TheGreatChris/ethernet-sniffer/model/RJMG1BD3B8K1ANR.STEP

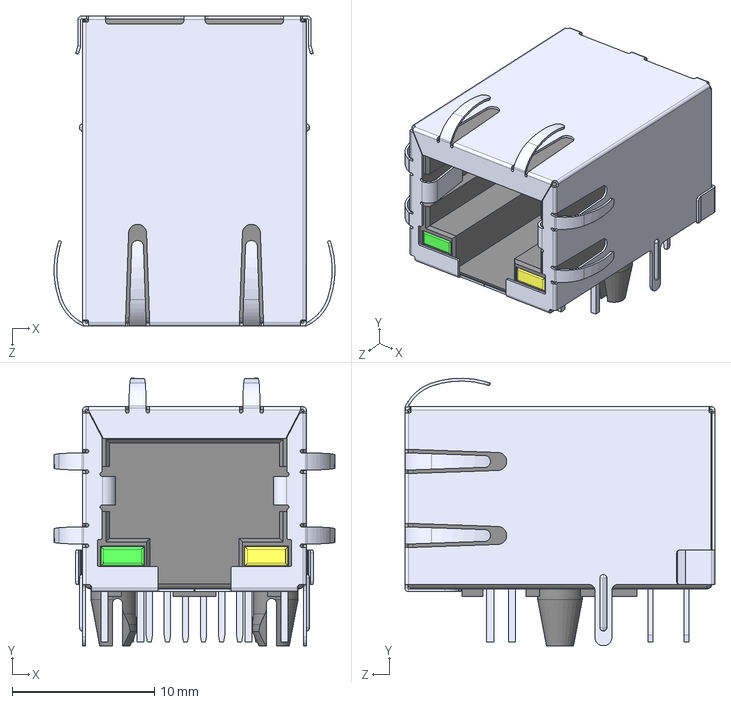
[picture p1: CAD file, 2020-06-23]
model/RJMG1BD3B8K1ANR.STEP
19.7 x 18.8 x 21.8 mm
