TheGreatChris/ethernet-sniffer/model/10118192C.stp

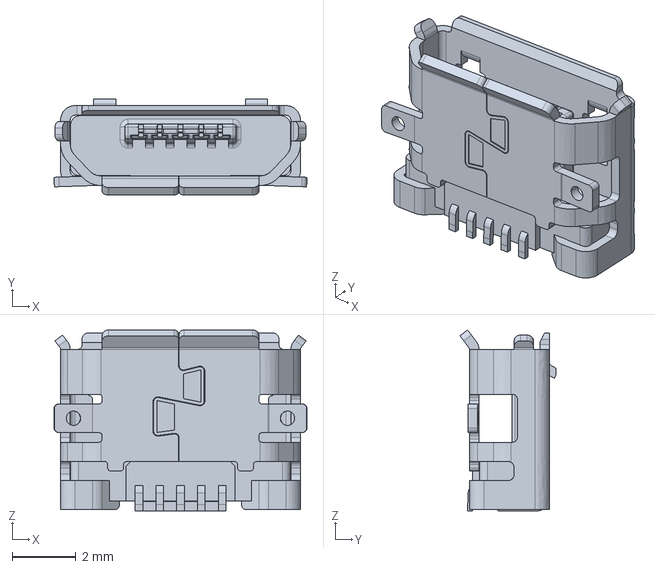
[picture p2: CAD file, 2020-06-23]
model/10118192C.stp
7.91 x 3.01 x 5.66 mm
