TheGreatChris/ethernet-sniffer/assembly/1.PNG

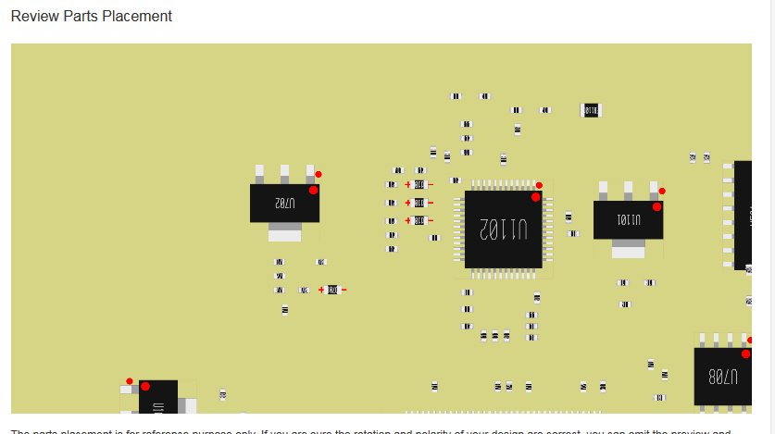
assembly/1.PNG
