TheGreatChris/ethernet-sniffer/assembly/2.PNG

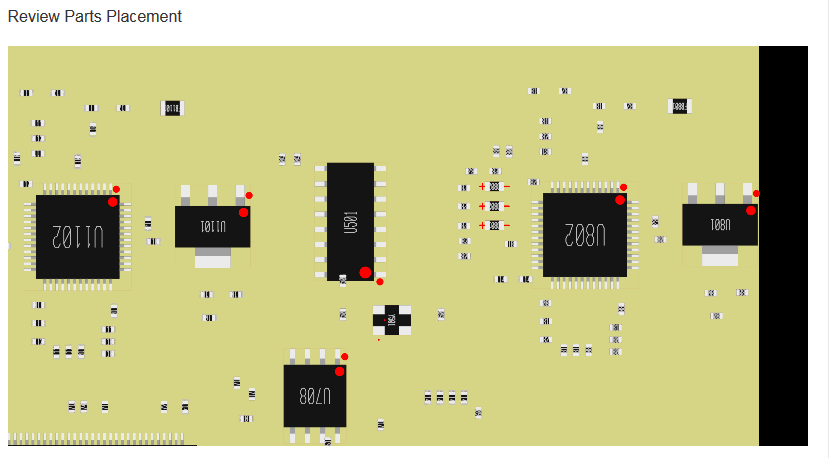
assembly/2.PNG
