TheGreatChris/ethernet-sniffer/assembly/3.PNG

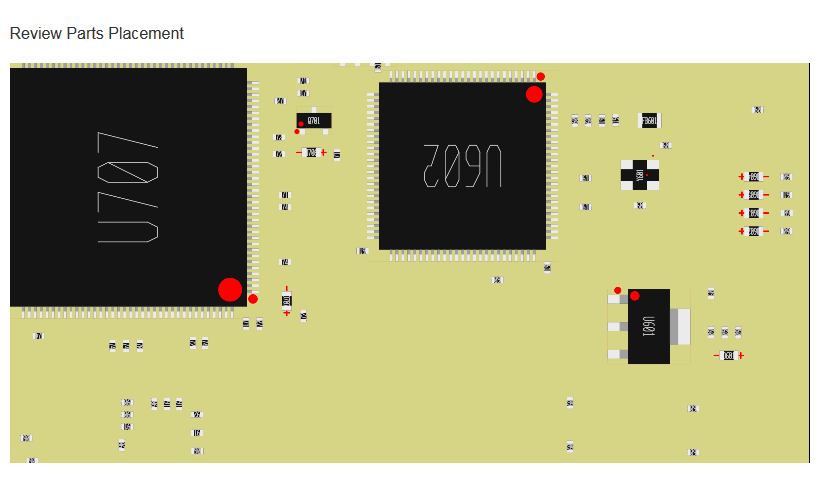
assembly/3.PNG
