TheGreatChris/ethernet-sniffer/assembly/4.PNG

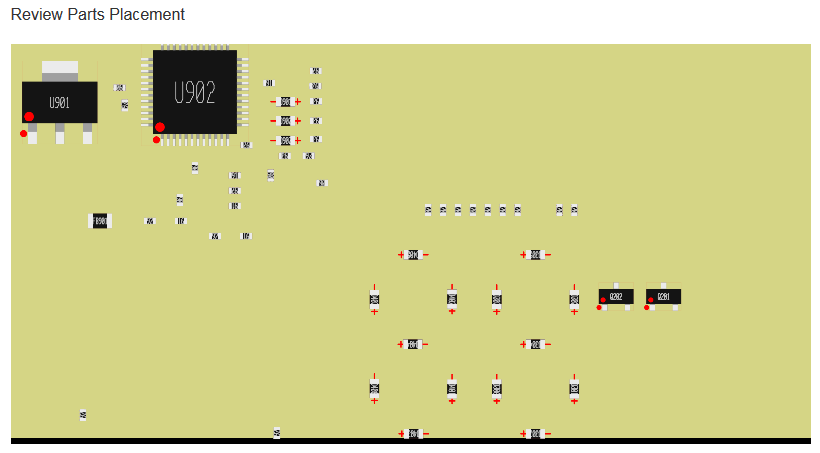
assembly/4.PNG
