TheGreatChris/ethernet-sniffer/assembly/5.PNG

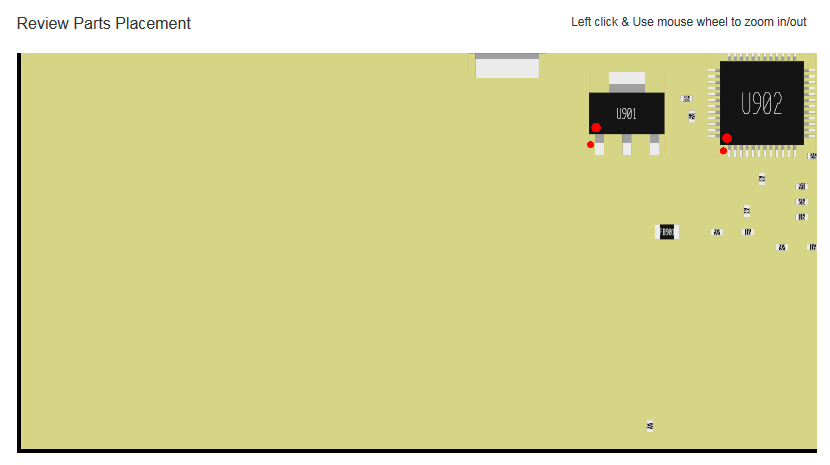
assembly/5.PNG
