TheGreatChris/ethernet-sniffer/assembly/6.PNG

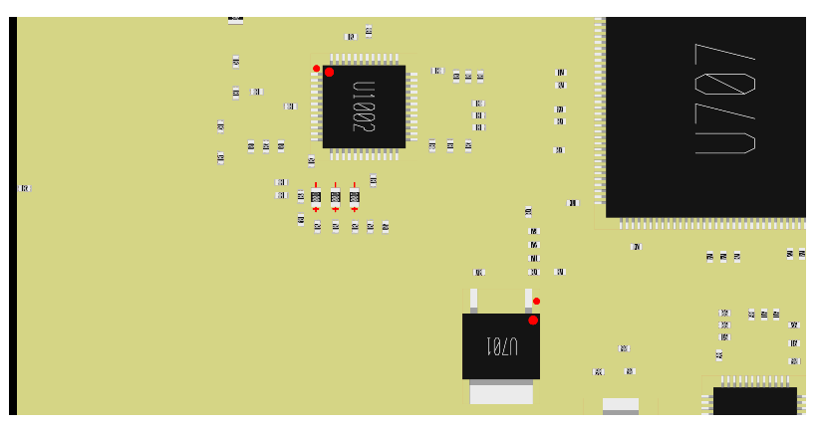
assembly/6.PNG
