TheGreatChris/ethernet-sniffer/assembly/7.PNG

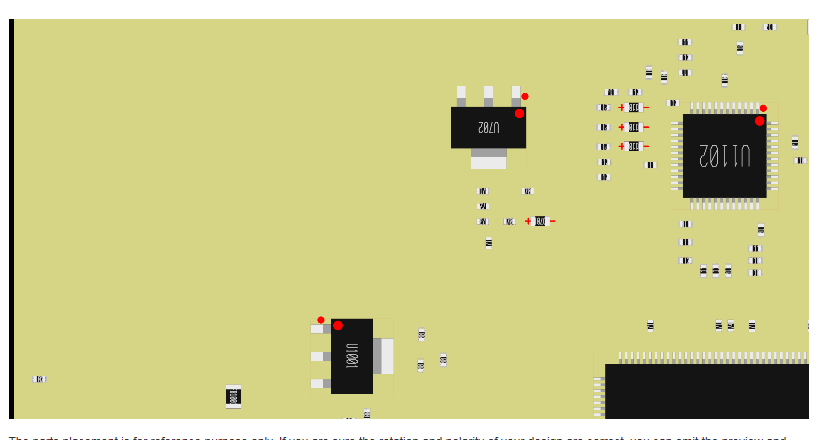
assembly/7.PNG
