TheGreatChris/ethernet-sniffer/assembly/total.png

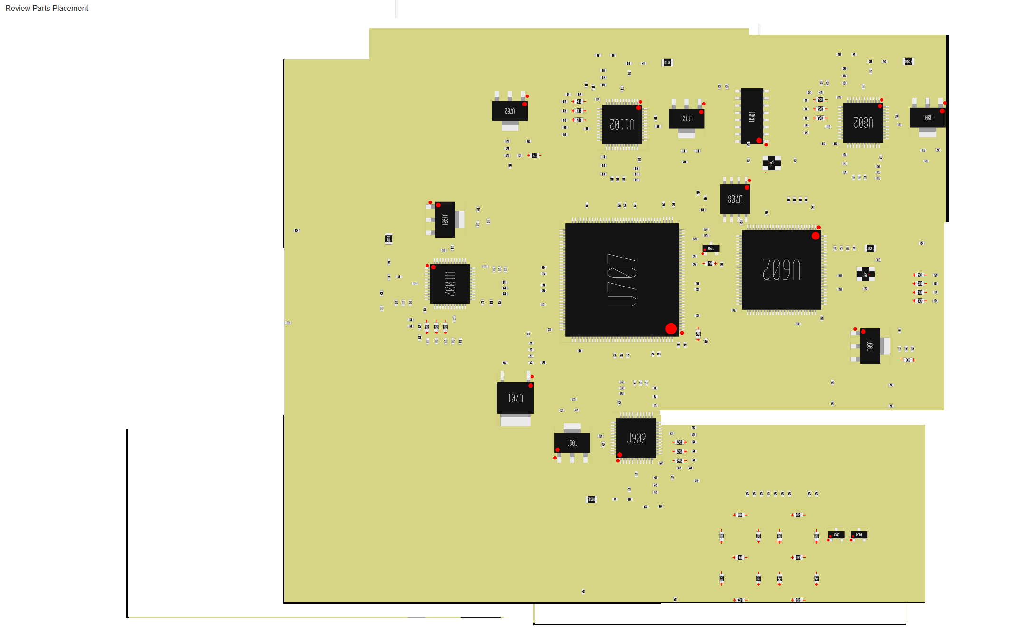
assembly/total.png
