TheGreatChris/ethernet-sniffer/ethernet-sniffer.kicad_pcb

## KiCad design ethernet-sniffer.kicad_pcb (2020-06-25)

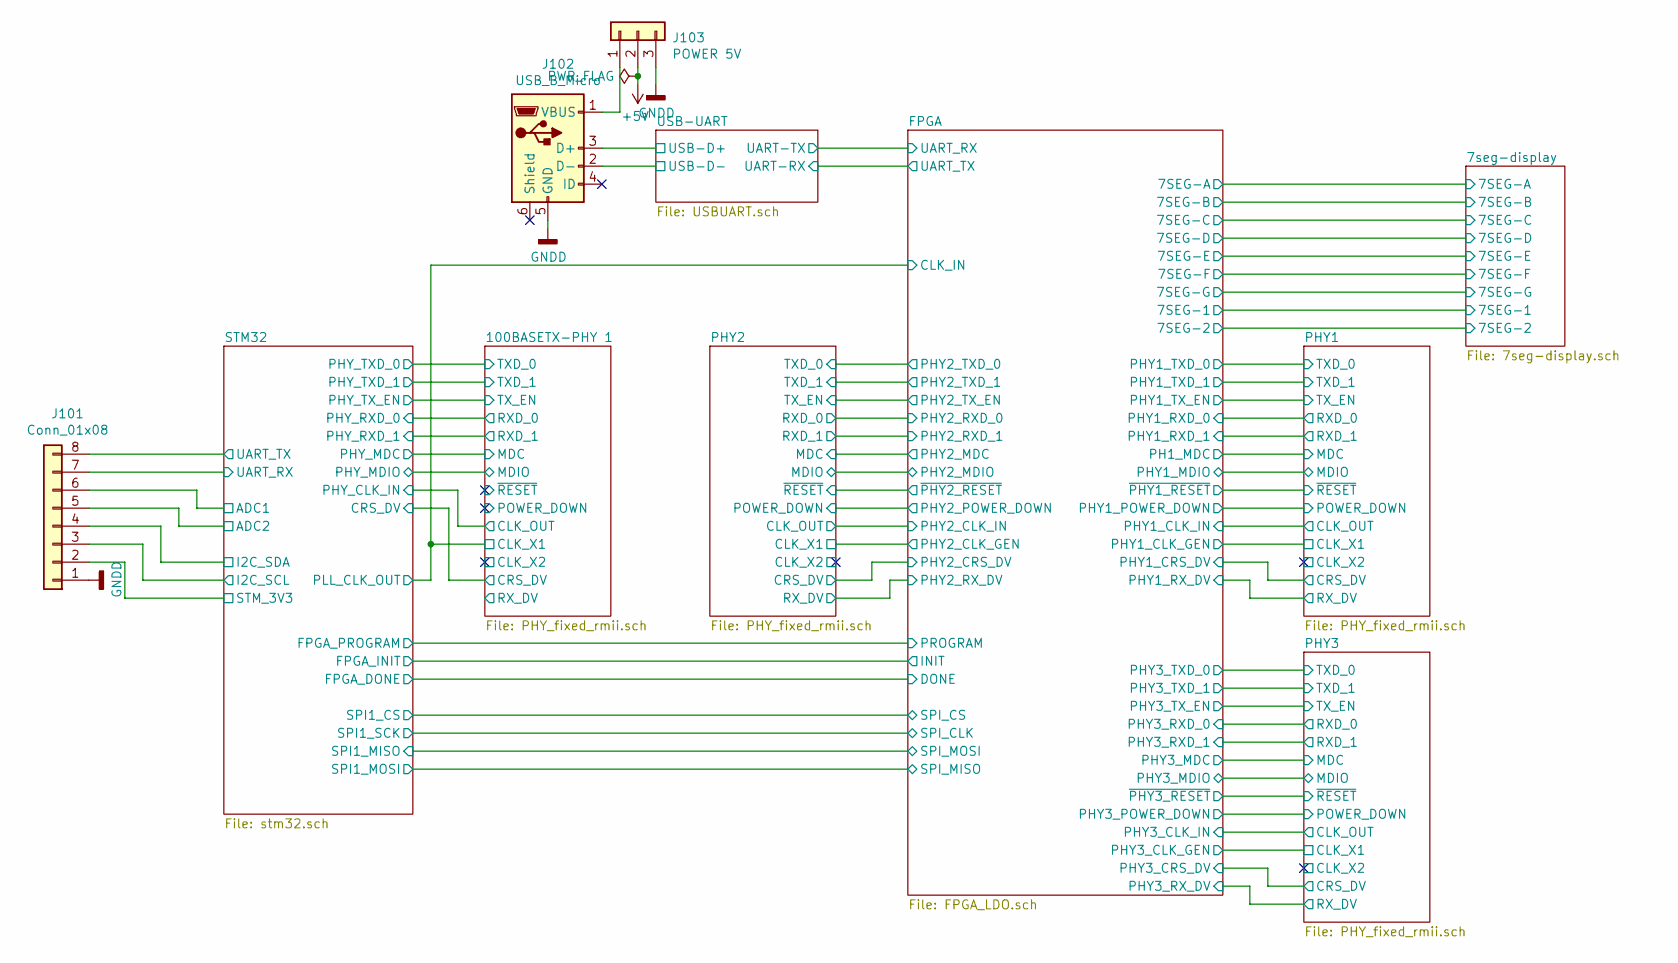
[picture p11: schematic ethernet-sniffer.sch]

Parts:
J101: Conn_01x08; PinHeader_1x08_P2.54mm_Vertical
J102: USB_B_Micro; USB_Micro-B_Amphenol_10103594-0001LF_Horizontal
J103: POWER 5V; PinHeader_1x03_P2.54mm_Vertical

Connections:
+5V: J103.2; also elsewhere on the board
/STM32/ADC1: J101.6; also elsewhere on the board
/STM32/ADC2: J101.5; also elsewhere on the board
/STM32/I2C_SCL: J101.3; also elsewhere on the board
/STM32/I2C_SDA: J101.4; also elsewhere on the board
/STM32/STM_3V3: J101.2; also elsewhere on the board
/STM32/UART_RX: J101.7; also elsewhere on the board
/STM32/UART_TX: J101.8; also elsewhere on the board
/USB-UART/USB-D+: J102.3 (D+); also elsewhere on the board
/USB-UART/USB-D-: J102.2 (D-); also elsewhere on the board
GNDD: J101.1, J102.5 (GND), J103.3; also elsewhere on the board
unnamed: J102.1 (VBUS), J103.1

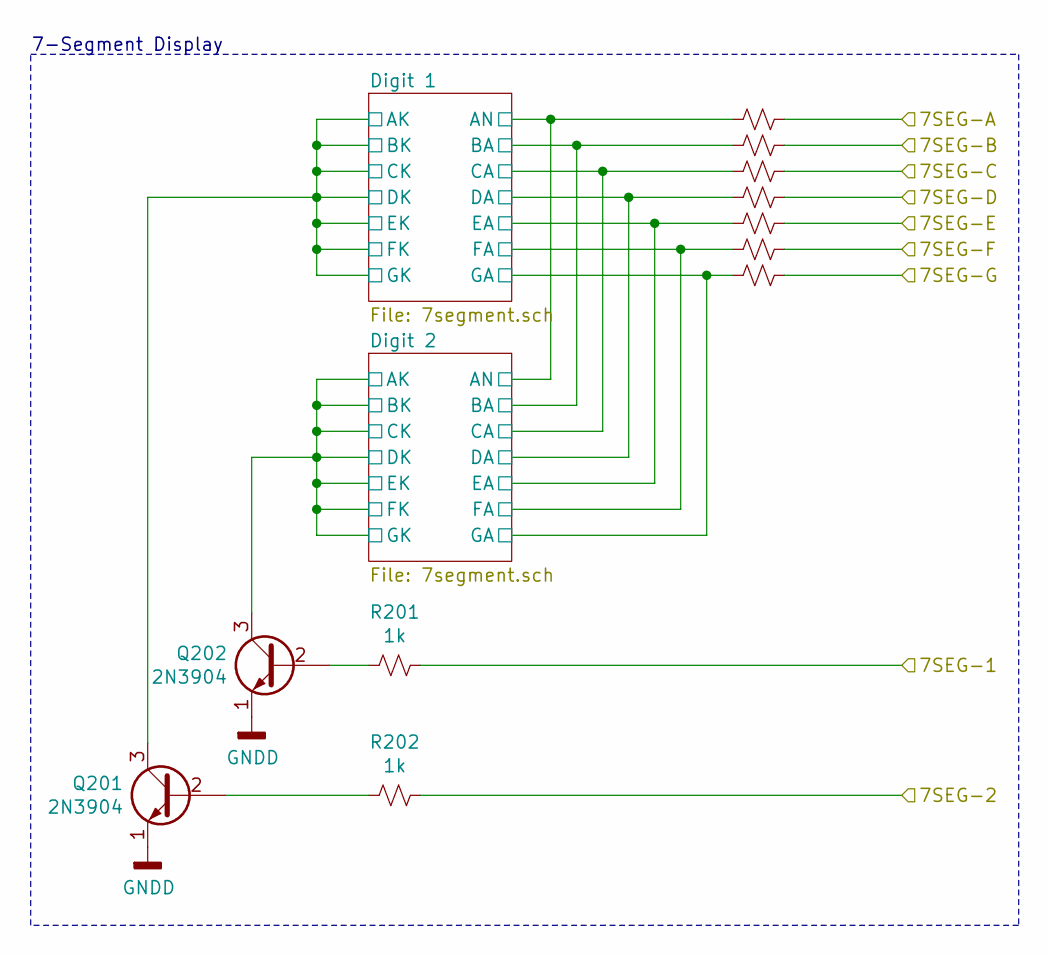
[picture p12: schematic 7seg-display.sch]

Parts:
Q201, Q202: 2N3904; SOT-23
R201, R202: 1k; R_0402_1005Metric
R203, R204, R205, R206, R207, R208, R209: 200; R_0402_1005Metric

Connections:
/7seg-display/7SEG-1: R201.1; also elsewhere on the board
/7seg-display/7SEG-2: R202.1; also elsewhere on the board
/7seg-display/7SEG-A: R203.1; also elsewhere on the board
/7seg-display/7SEG-B: R204.1; also elsewhere on the board
/7seg-display/7SEG-C: R205.1; also elsewhere on the board
/7seg-display/7SEG-D: R206.1; also elsewhere on the board
/7seg-display/7SEG-E: R207.1; also elsewhere on the board
/7seg-display/7SEG-F: R208.1; also elsewhere on the board
/7seg-display/7SEG-G: R209.1; also elsewhere on the board
/7seg-display/Digit 1/AK: Q201.3 (C); also elsewhere on the board
/7seg-display/Digit 1/AN: R203.2; also elsewhere on the board
/7seg-display/Digit 1/BA: R204.2; also elsewhere on the board
/7seg-display/Digit 1/CA: R205.2; also elsewhere on the board
/7seg-display/Digit 1/DA: R206.2; also elsewhere on the board
/7seg-display/Digit 1/EA: R207.2; also elsewhere on the board
/7seg-display/Digit 1/FA: R208.2; also elsewhere on the board
/7seg-display/Digit 1/GA: R209.2; also elsewhere on the board
/7seg-display/Digit 2/AK: Q202.3 (C); also elsewhere on the board
GNDD: Q201.1 (E), Q202.1 (E); also elsewhere on the board
unnamed: Q201.2 (B), R202.2
unnamed: Q202.2 (B), R201.2

Notes on the sheet:
7-Segment Display

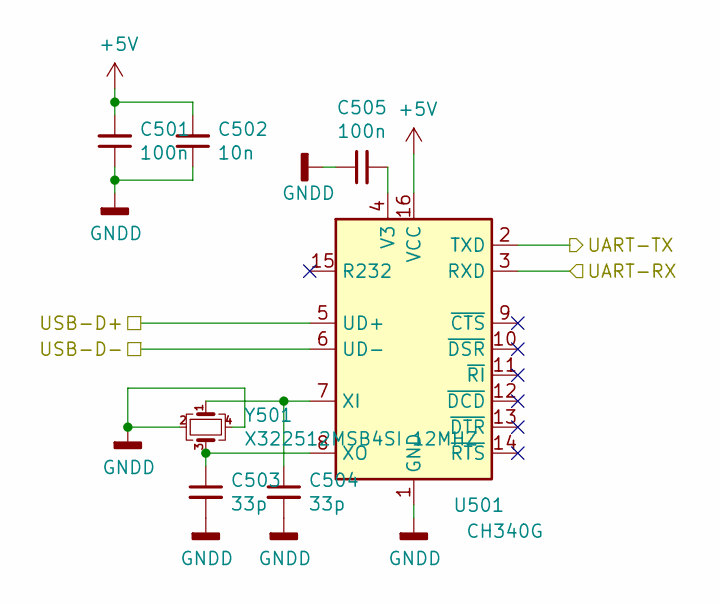
[picture p13: schematic USBUART.sch]

Parts:
C501, C505: 100n; C_0402_1005Metric
C502: 10n; C_0402_1005Metric
C503, C504: 33p; C_0402_1005Metric
U501: CH340G; SOIC-16_3.9x9.9mm_P1.27mm
Y501: X322512MSB4SI 12MHZ; Crystal_SMD_3225-4Pin_3.2x2.5mm

Connections:
+5V: C501.2, C502.2, U501.16 (VCC); also elsewhere on the board
/USB-UART/UART-RX: U501.3 (RXD); also elsewhere on the board
/USB-UART/UART-TX: U501.2 (TXD); also elsewhere on the board
/USB-UART/USB-D+: U501.5 (UD+); also elsewhere on the board
/USB-UART/USB-D-: U501.6 (UD-); also elsewhere on the board
GNDD: C501.1, C502.1, C503.2, C504.2, C505.1, U501.1 (GND), Y501.2, Y501.4; also elsewhere on the board
unnamed: C503.1, U501.8 (XO), Y501.3
unnamed: C504.1, U501.7 (XI), Y501.1
unnamed: C505.2, U501.4 (V3)

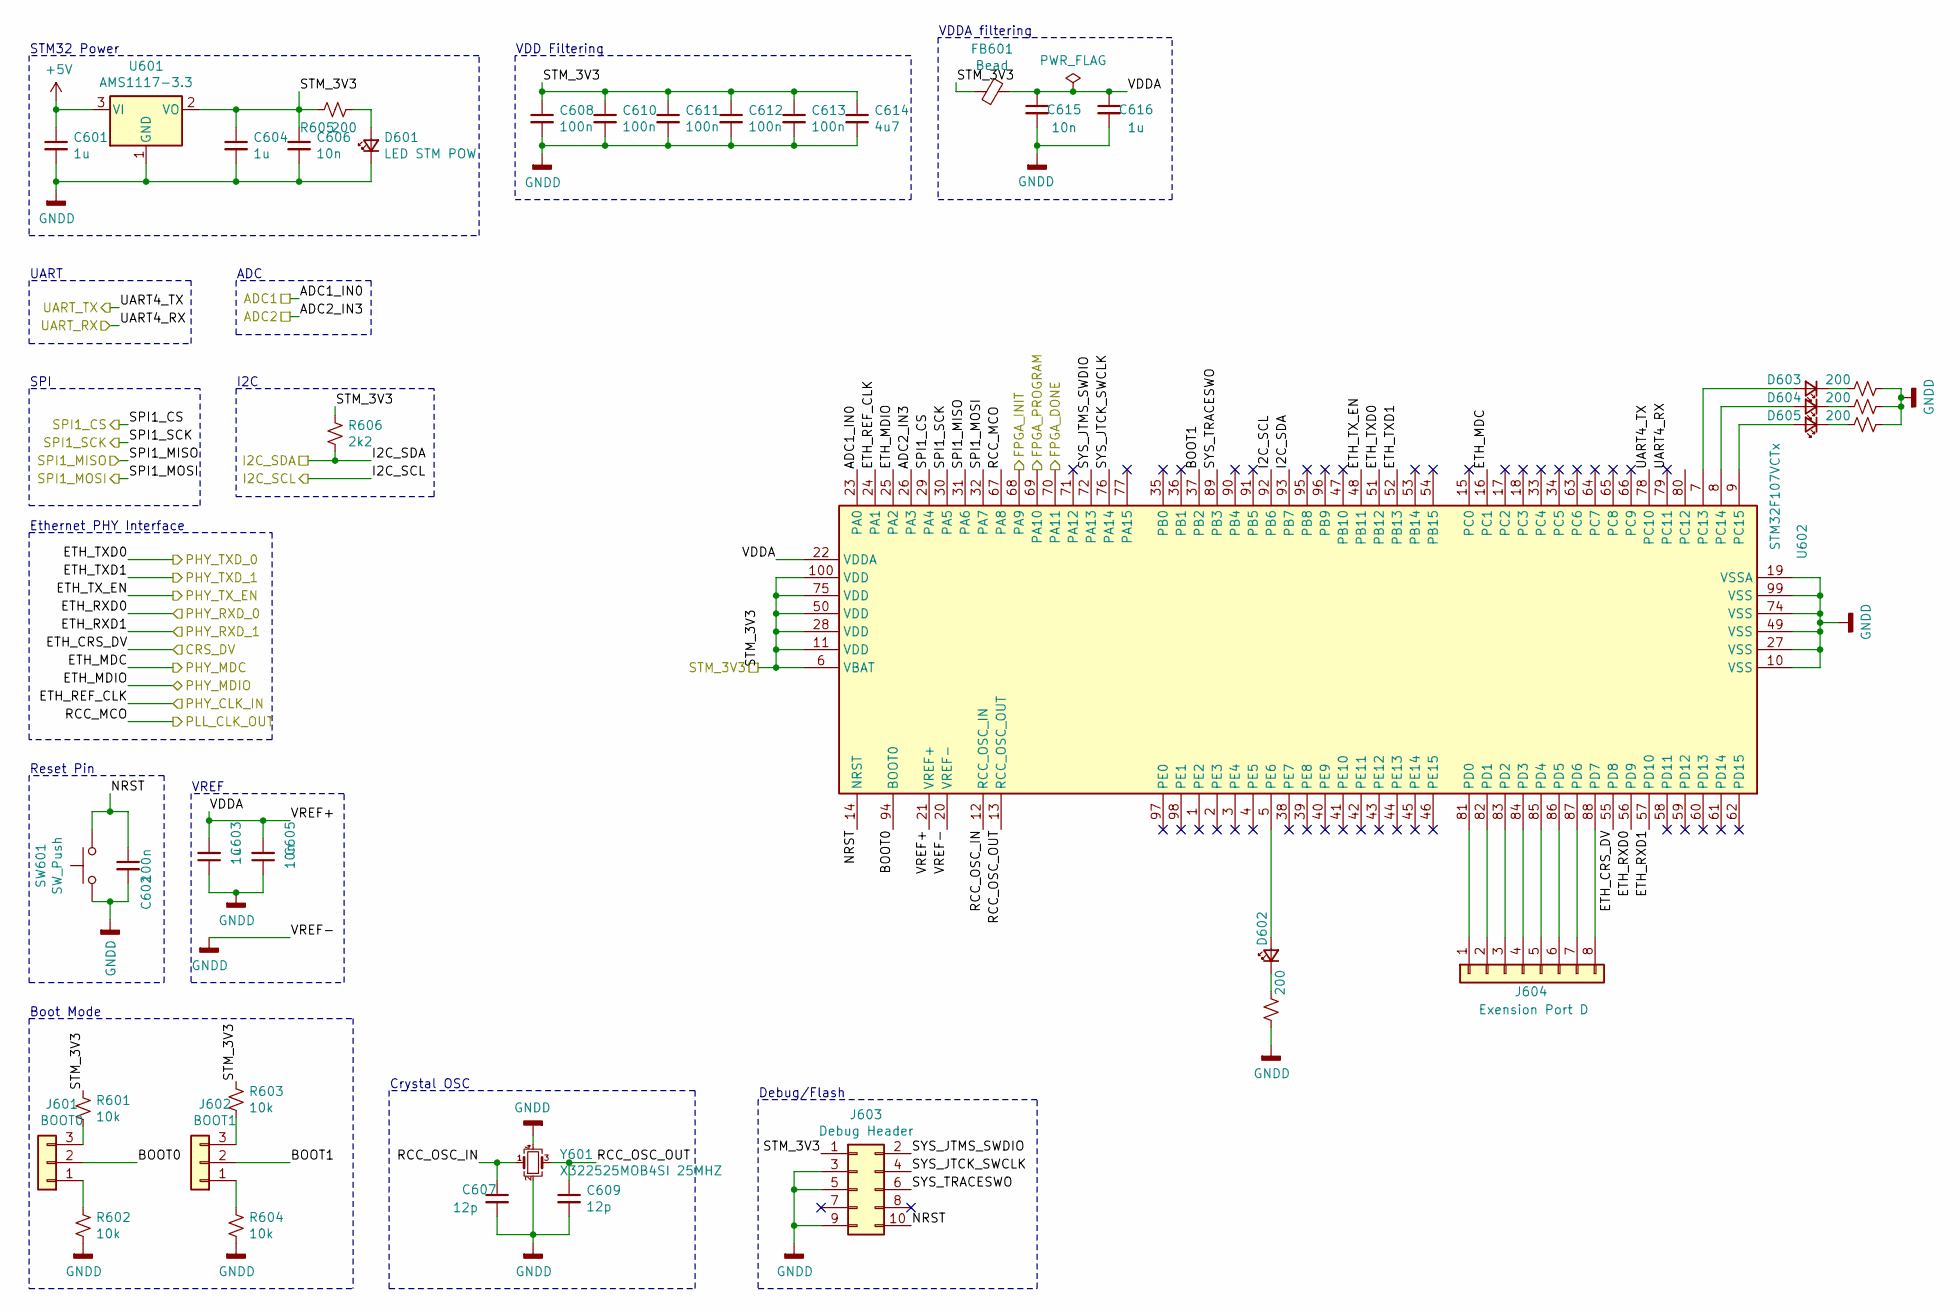
[picture p14: schematic stm32.sch]

Parts:
C601, C603, C604, C616: 1u; C_0402_1005Metric
C602, C608, C610, C611, C612, C613: 100n; C_0402_1005Metric
C605, C606, C615: 10n; C_0402_1005Metric
C607, C609: 12p; C_0402_1005Metric
C614: 4u7; C_0402_1005Metric
D601: LED STM POW; LED_0603_1608Metric
D602, D603, D604, D605: LED_Small; LED_0603_1608Metric
FB601: Bead; L_0805_2012Metric
J601: BOOT0; PinHeader_1x03_P2.54mm_Vertical
J602: BOOT1; PinHeader_1x03_P2.54mm_Vertical
J603: Debug Header; PinHeader_2x05_P2.54mm_Vertical
J604: Exension Port D; PinHeader_1x08_P2.54mm_Vertical
R601, R602, R603, R604: 10k; R_0402_1005Metric
R605, R607, R608, R609, R610: 200; R_0402_1005Metric
R606: 2k2; R_0402_1005Metric
SW601: SW_Push; SW_Push_SPST_NO_Alps_SKRK
U601: AMS1117-3.3; SOT-223-3_TabPin2
U602: STM32F107VCTx; LQFP-100_14x14mm_P0.5mm
Y601: X322525MOB4SI 25MHZ; Crystal_SMD_3225-4Pin_3.2x2.5mm

Connections:
+5V: C601.1, U601.3 (VI); also elsewhere on the board
/100BASETX-PHY 1/CLK_OUT: U602.24 (PA1); also elsewhere on the board
/100BASETX-PHY 1/CRS_DV: U602.55 (PD8); also elsewhere on the board
/100BASETX-PHY 1/MDC: U602.16 (PC1); also elsewhere on the board
/100BASETX-PHY 1/MDIO: U602.25 (PA2); also elsewhere on the board
/FPGA/CLK_IN: U602.67 (PA8); also elsewhere on the board
/FPGA/DONE: U602.70 (PA11); also elsewhere on the board
/STM32/ADC1: U602.23 (PA0); also elsewhere on the board
/STM32/ADC2: U602.26 (PA3); also elsewhere on the board
/STM32/BOOT0: J601.2, U602.94 (BOOT0)
/STM32/BOOT1: J602.2, U602.37 (PB2)
/STM32/FPGA_INIT: U602.68 (PA9); also elsewhere on the board
/STM32/FPGA_PROGRAM: U602.69 (PA10); also elsewhere on the board
/STM32/I2C_SCL: U602.92 (PB6); also elsewhere on the board
/STM32/I2C_SDA: R606.2, U602.93 (PB7); also elsewhere on the board
/STM32/NRST: C602.1, J603.10, SW601.2, U602.14 (NRST)
/STM32/PHY_RXD_0: U602.56 (PD9); also elsewhere on the board
/STM32/PHY_RXD_1: U602.57 (PD10); also elsewhere on the board
/STM32/PHY_TXD_0: U602.51 (PB12); also elsewhere on the board
/STM32/PHY_TXD_1: U602.52 (PB13); also elsewhere on the board
/STM32/PHY_TX_EN: U602.48 (PB11); also elsewhere on the board
/STM32/RCC_OSC_IN: C607.1, U602.12 (RCC_OSC_IN), Y601.1
/STM32/RCC_OSC_OUT: C609.1, U602.13 (RCC_OSC_OUT), Y601.3
/STM32/SPI1_CS: U602.29 (PA4); also elsewhere on the board
/STM32/SPI1_MISO: U602.31 (PA6); also elsewhere on the board
/STM32/SPI1_MOSI: U602.32 (PA7); also elsewhere on the board
/STM32/SPI1_SCK: U602.30 (PA5); also elsewhere on the board
/STM32/STM_3V3: C604.1, C606.1, C608.1, C610.1, C611.1, C612.1, C613.1, C614.1, FB601.2, J603.1, R601.1, R603.1, R605.1, R606.1, U601.2 (VO), U602.6 (VBAT), U602.11 (VDD), U602.28 (VDD), U602.50 (VDD), U602.75 (VDD), U602.100 (VDD); also elsewhere on the board
/STM32/SYS_JTCK_SWCLK: J603.4, U602.76 (PA14)
/STM32/SYS_JTMS_SWDIO: J603.2, U602.72 (PA13)
/STM32/SYS_TRACESWO: J603.6, U602.89 (PB3)
/STM32/UART_RX: U602.79 (PC11); also elsewhere on the board
/STM32/UART_TX: U602.78 (PC10); also elsewhere on the board
/STM32/VDDA: C603.2, C605.2, C615.1, C616.1, FB601.1, U602.21 (VREF+), U602.22 (VDDA)
GNDD: C601.2, C602.2, C603.1, C604.2, C605.1, C606.2, C607.2, C608.2, C609.2, C610.2, C611.2, C612.2, C613.2, C614.2, C615.2, C616.2, D601.1 (K), J603.3, J603.5, J603.9, R602.2, R604.2, R607.1, R608.1, R609.1, R610.1, SW601.1, U601.1 (GND), U602.10 (VSS), U602.19 (VSSA), U602.20 (VREF-), U602.27 (VSS), U602.49 (VSS), U602.74 (VSS), U602.99 (VSS), Y601.2, Y601.4; also elsewhere on the board
unnamed: D601.2 (A), R605.2
unnamed: D602.1 (K), R607.2
unnamed: D602.2 (A), U602.5 (PE6)
unnamed: D603.1 (K), R608.2
unnamed: D603.2 (A), U602.7 (PC13)
unnamed: D604.1 (K), R609.2
unnamed: D604.2 (A), U602.8 (PC14)
unnamed: D605.1 (K), R610.2
unnamed: D605.2 (A), U602.9 (PC15)
unnamed: J601.1, R602.1
unnamed: J601.3, R601.2
unnamed: J602.1, R604.1
unnamed: J602.3, R603.2
unnamed: J604.1, U602.81 (PD0)
unnamed: J604.2, U602.82 (PD1)
unnamed: J604.3, U602.83 (PD2)
unnamed: J604.4, U602.84 (PD3)
unnamed: J604.5, U602.85 (PD4)
unnamed: J604.6, U602.86 (PD5)
unnamed: J604.7, U602.87 (PD6)
unnamed: J604.8, U602.88 (PD7)

Notes on the sheet:
Reset Pin
Boot Mode
VREF
Crystal OSC
Debug/Flash
Ethernet PHY Interface
SPI
STM32 Power
VDD Filtering
UART
ADC
VDDA filtering
I2C

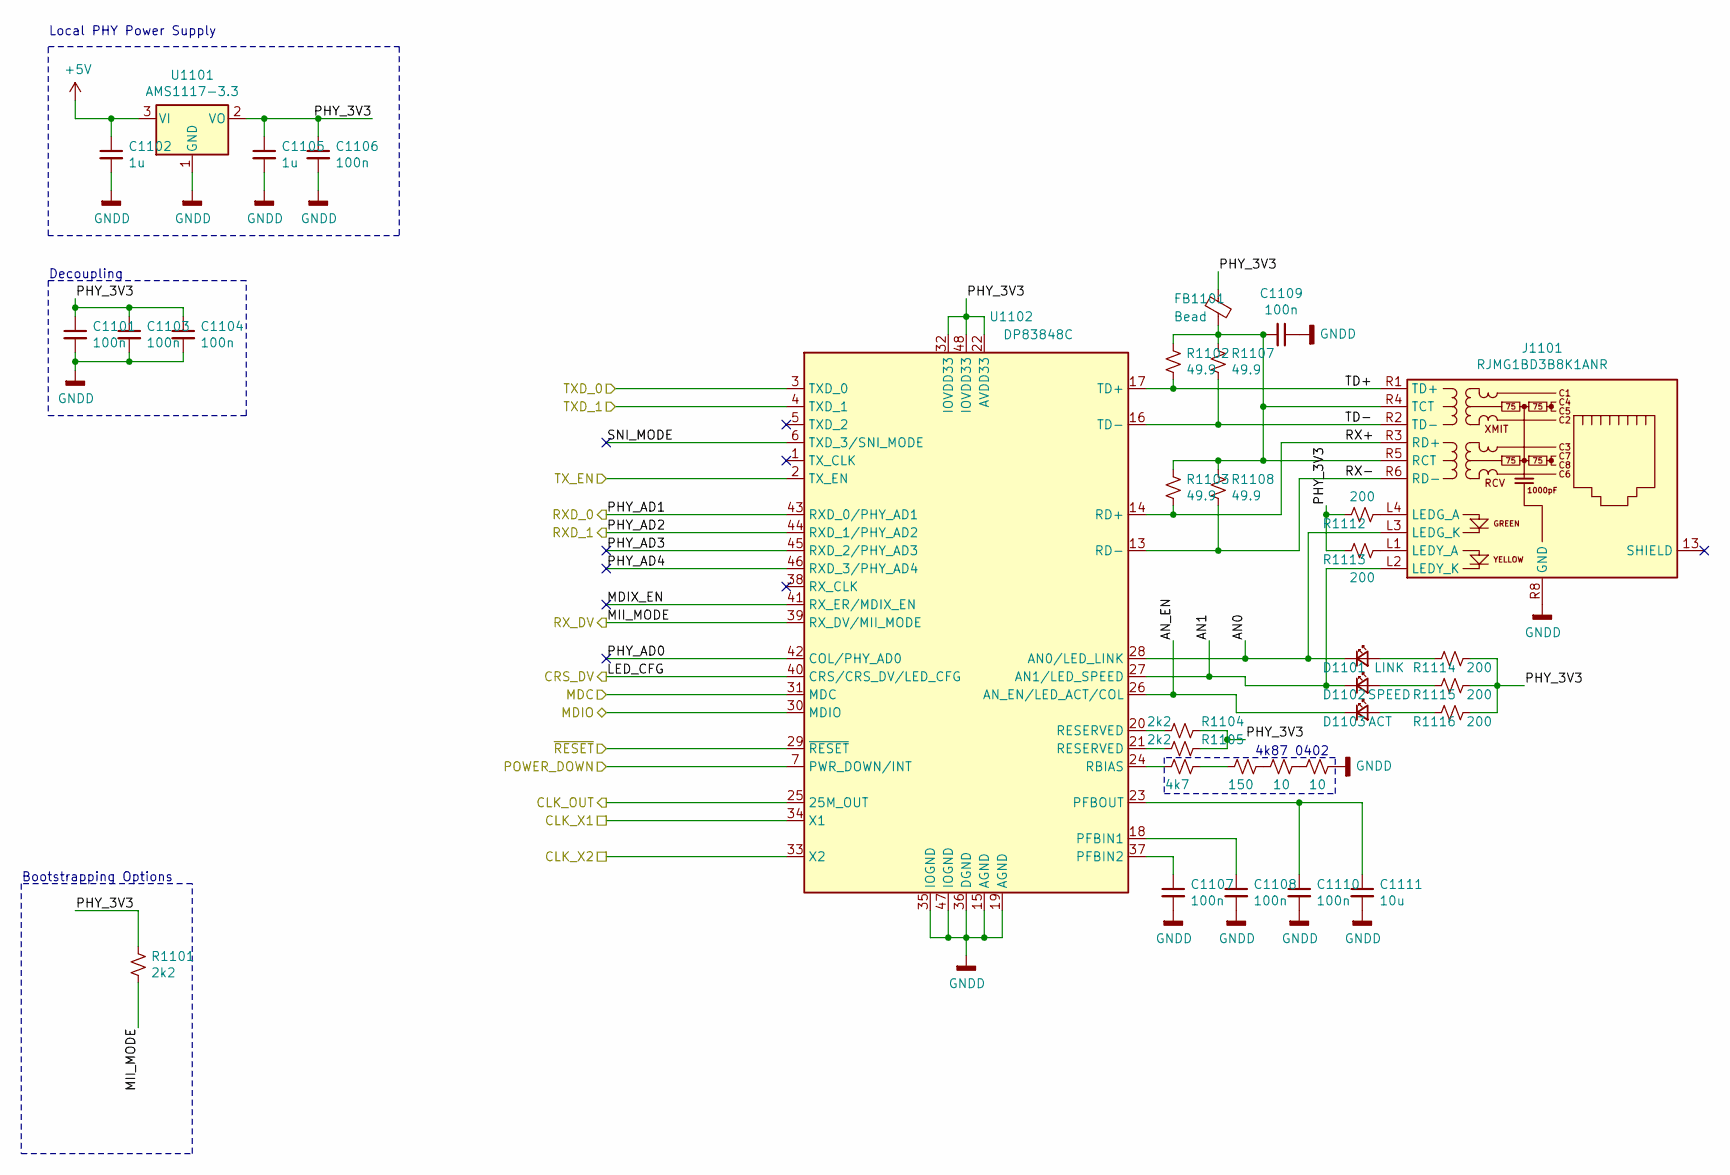
[picture p15: schematic PHY_fixed_rmii.sch]

Parts:
C702, C705: 1u; C_0402_1005Metric
C706, C707, C708, C709, C710, C1001, C1003, C1004: 100n; C_0402_1005Metric
C711: 10u; C_0402_1005Metric
D701: LINK; LED_0603_1608Metric
D702: SPEED; LED_0603_1608Metric
D703: ACT; LED_0603_1608Metric
FB701: Bead; L_0805_2012Metric
J701: RJMG1BD3B8K1ANR; RJ45_Amphenol_RJMG1BD3B8K1ANR
R701, R704, R705: 2k2; R_0402_1005Metric
R702, R703, R707, R708: 49.9; R_0402_1005Metric
R706: 4k7; R_0402_1005Metric
R709: 150; R_0402_1005Metric
R710, R711: 10; R_0402_1005Metric
R712, R713, R714, R715, R716: 200; R_0402_1005Metric
U701: AMS1117-3.3; SOT-223-3_TabPin2
U702: DP83848C; LQFP-48_7x7mm_P0.5mm

Connections:
+5V: C702.1, U701.3 (VI); also elsewhere on the board
/100BASETX-PHY 1/AN0: D701.1 (K), J701.L3 (LEDG_K), U702.28 (AN0/LED_LINK)
/100BASETX-PHY 1/AN1: D702.1 (K), J701.L2 (LEDY_K), U702.27 (AN1/LED_SPEED)
/100BASETX-PHY 1/AN_EN: D703.1 (K), U702.26 (AN_EN/LED_ACT/COL)
/100BASETX-PHY 1/CLK_OUT: U702.25 (25M_OUT); also elsewhere on the board
/100BASETX-PHY 1/CLK_X2: U702.33 (X2)
/100BASETX-PHY 1/CRS_DV: U702.40 (CRS/CRS_DV/LED_CFG); also elsewhere on the board
/100BASETX-PHY 1/MDC: U702.31 (MDC); also elsewhere on the board
/100BASETX-PHY 1/MDIO: U702.30 (MDIO); also elsewhere on the board
/100BASETX-PHY 1/MDIX_EN: U702.41 (RX_ER/MDIX_EN)
/100BASETX-PHY 1/PHY_AD0: U702.42 (COL/PHY_AD0)
/100BASETX-PHY 1/PHY_AD3: U702.45 (RXD_2/PHY_AD3)
/100BASETX-PHY 1/PHY_AD4: U702.46 (RXD_3/PHY_AD4)
/100BASETX-PHY 1/POWER_DOWN: U702.7 (PWR_DOWN/INT)
/100BASETX-PHY 1/RX+: J701.R3 (RD+), R703.2, U702.14 (RD+)
/100BASETX-PHY 1/RX-: J701.R6 (RD-), R708.2, U702.13 (RD-)
/100BASETX-PHY 1/RX_DV: R701.2, U702.39 (RX_DV/MII_MODE)
/100BASETX-PHY 1/SNI_MODE: U702.6 (TXD_3/SNI_MODE)
/100BASETX-PHY 1/TD+: J701.R1 (TD+), R702.2, U702.17 (TD+)
/100BASETX-PHY 1/TD-: J701.R2 (TD-), R707.2, U702.16 (TD-)
/100BASETX-PHY 1/~RESET: U702.29 (~RESET~)
/FPGA/CLK_IN: U702.34 (X1); also elsewhere on the board
/STM32/PHY_RXD_0: U702.43 (RXD_0/PHY_AD1); also elsewhere on the board
/STM32/PHY_RXD_1: U702.44 (RXD_1/PHY_AD2); also elsewhere on the board
/STM32/PHY_TXD_0: U702.3 (TXD_0); also elsewhere on the board
/STM32/PHY_TXD_1: U702.4 (TXD_1); also elsewhere on the board
/STM32/PHY_TX_EN: U702.2 (TX_EN); also elsewhere on the board
GNDD: C702.2, C705.2, C706.2, C707.2, C708.2, C709.1, C710.2, C711.2, C1001.2, C1003.2, C1004.2, J701.R8 (GND), R711.1, U701.1 (GND), U702.15 (AGND), U702.19 (AGND), U702.35 (IOGND), U702.36 (DGND), U702.47 (IOGND); also elsewhere on the board
unnamed: C707.1, U702.37 (PFBIN2)
unnamed: C708.1, U702.18 (PFBIN1)
unnamed: C709.2, FB701.2, J701.R4 (TCT), J701.R5 (RCT), R702.1, R703.1, R707.1, R708.1
unnamed: C710.1, C711.1, U702.23 (PFBOUT)
unnamed: D701.2 (A), R714.2
unnamed: D702.2 (A), R715.2
unnamed: D703.2 (A), R716.2
unnamed: J701.L1 (LEDY_A), R713.1
unnamed: J701.L4 (LEDG_A), R712.1
unnamed: R704.2, U702.20 (RESERVED)
unnamed: R705.2, U702.21 (RESERVED)
unnamed: R706.1, R709.2
unnamed: R706.2, U702.24 (RBIAS)
unnamed: R709.1, R710.2
unnamed: R710.1, R711.2

Parts of its further copies:
C701, C703, C704, C801, C803, C804, C806, C807, C808, C809, C810, C1006, C1007, C1008, C1009, C1010, C1101, C1103, C1104, C1106, C1107, C1108, C1109, C1110: 100n; C_0402_1005Metric
C802, C805, C1002, C1005, C1102, C1105: 1u; C_0402_1005Metric
C811, C1011, C1111: 10u; C_0402_1005Metric
D801, D1001, D1101: LINK; LED_0603_1608Metric
D802, D1002, D1102: SPEED; LED_0603_1608Metric
D803, D1003, D1103: ACT; LED_0603_1608Metric
FB801, FB1001, FB1101: Bead; L_0805_2012Metric
J801, J1001, J1101: RJMG1BD3B8K1ANR; RJ45_Amphenol_RJMG1BD3B8K1ANR
R801, R804, R805, R1001, R1004, R1005, R1101, R1104, R1105: 2k2; R_0402_1005Metric
R802, R803, R807, R808, R1002, R1003, R1007, R1008, R1102, R1103, R1107, R1108: 49.9; R_0402_1005Metric
R806, R1006, R1106: 4k7; R_0402_1005Metric
R809, R1009, R1109: 150; R_0402_1005Metric
R810, R811, R1010, R1011, R1110, R1111: 10; R_0402_1005Metric
R812, R813, R814, R815, R816, R1012, R1013, R1014, R1015, R1016, R1112, R1113, R1114, R1115, R1116: 200; R_0402_1005Metric
U801, U1001, U1101: AMS1117-3.3; SOT-223-3_TabPin2
U802, U1002, U1102: DP83848C; LQFP-48_7x7mm_P0.5mm

Connections of its further copies:
+5V: C802.1, C1002.1, C1102.1, U801.3 (VI), U1001.3 (VI), U1101.3 (VI); also elsewhere on the board
/FPGA/PHY1_POWER_DOWN: U1102.7 (PWR_DOWN/INT); also elsewhere on the board
/FPGA/PHY1_RXD_0: U1102.43 (RXD_0/PHY_AD1); also elsewhere on the board
/FPGA/PHY1_RXD_1: U1102.44 (RXD_1/PHY_AD2); also elsewhere on the board
/FPGA/PHY1_RX_DV: R1101.2, U1102.39 (RX_DV/MII_MODE); also elsewhere on the board
/FPGA/PHY1_TXD_0: U1102.3 (TXD_0); also elsewhere on the board
/FPGA/PHY1_TXD_1: U1102.4 (TXD_1); also elsewhere on the board
/FPGA/PHY1_TX_EN: U1102.2 (TX_EN); also elsewhere on the board
/FPGA/PHY2_POWER_DOWN: U1002.7 (PWR_DOWN/INT); also elsewhere on the board
/FPGA/PHY2_RXD_0: U1002.43 (RXD_0/PHY_AD1); also elsewhere on the board
/FPGA/PHY2_RXD_1: U1002.44 (RXD_1/PHY_AD2); also elsewhere on the board
/FPGA/PHY2_RX_DV: R1001.2, U1002.39 (RX_DV/MII_MODE); also elsewhere on the board
/FPGA/PHY2_TXD_0: U1002.3 (TXD_0); also elsewhere on the board
/FPGA/PHY2_TXD_1: U1002.4 (TXD_1); also elsewhere on the board
/FPGA/PHY2_TX_EN: U1002.2 (TX_EN); also elsewhere on the board
/FPGA/PHY3_POWER_DOWN: U802.7 (PWR_DOWN/INT); also elsewhere on the board
/FPGA/PHY3_RXD_0: U802.43 (RXD_0/PHY_AD1); also elsewhere on the board
/FPGA/PHY3_RXD_1: U802.44 (RXD_1/PHY_AD2); also elsewhere on the board
/FPGA/PHY3_RX_DV: R801.2, U802.39 (RX_DV/MII_MODE); also elsewhere on the board
/FPGA/PHY3_TXD_0: U802.3 (TXD_0); also elsewhere on the board
/FPGA/PHY3_TXD_1: U802.4 (TXD_1); also elsewhere on the board
/FPGA/PHY3_TX_EN: U802.2 (TX_EN); also elsewhere on the board
/FPGA/~PHY1_RESET: U1102.29 (~RESET~); also elsewhere on the board
/FPGA/~PHY2_RESET: U1002.29 (~RESET~); also elsewhere on the board
/FPGA/~PHY3_RESET: U802.29 (~RESET~); also elsewhere on the board
/PHY1/AN0: D1101.1 (K), J1101.L3 (LEDG_K), U1102.28 (AN0/LED_LINK)
/PHY1/AN1: D1102.1 (K), J1101.L2 (LEDY_K), U1102.27 (AN1/LED_SPEED)
/PHY1/AN_EN: D1103.1 (K), U1102.26 (AN_EN/LED_ACT/COL)
/PHY1/CLK_OUT: U1102.25 (25M_OUT); also elsewhere on the board
/PHY1/CLK_X1: U1102.34 (X1); also elsewhere on the board
/PHY1/CLK_X2: U1102.33 (X2)
/PHY1/CRS_DV: U1102.40 (CRS/CRS_DV/LED_CFG); also elsewhere on the board
/PHY1/MDC: U1102.31 (MDC); also elsewhere on the board
/PHY1/MDIO: U1102.30 (MDIO); also elsewhere on the board
/PHY1/MDIX_EN: U1102.41 (RX_ER/MDIX_EN)
/PHY1/PHY_3V3: C1101.1, C1103.1, C1104.1, C1105.1, C1106.1, FB1101.1, R1101.1, R1104.1, R1105.1, R1112.2, R1113.2, R1114.1, R1115.1, R1116.1, U1101.2 (VO), U1102.22 (AVDD33), U1102.32 (IOVDD33), U1102.48 (IOVDD33)
/PHY1/PHY_AD0: U1102.42 (COL/PHY_AD0)
/PHY1/PHY_AD3: U1102.45 (RXD_2/PHY_AD3)
/PHY1/PHY_AD4: U1102.46 (RXD_3/PHY_AD4)
/PHY1/RX+: J1101.R3 (RD+), R1103.2, U1102.14 (RD+)
/PHY1/RX-: J1101.R6 (RD-), R1108.2, U1102.13 (RD-)
/PHY1/SNI_MODE: U1102.6 (TXD_3/SNI_MODE)
/PHY1/TD+: J1101.R1 (TD+), R1102.2, U1102.17 (TD+)
/PHY1/TD-: J1101.R2 (TD-), R1107.2, U1102.16 (TD-)
/PHY2/AN0: D1001.1 (K), J1001.L3 (LEDG_K), U1002.28 (AN0/LED_LINK)
/PHY2/AN1: D1002.1 (K), J1001.L2 (LEDY_K), U1002.27 (AN1/LED_SPEED)
/PHY2/AN_EN: D1003.1 (K), U1002.26 (AN_EN/LED_ACT/COL)
/PHY2/CLK_OUT: U1002.25 (25M_OUT); also elsewhere on the board
/PHY2/CLK_X1: U1002.34 (X1); also elsewhere on the board
/PHY2/CLK_X2: U1002.33 (X2)
/PHY2/CRS_DV: U1002.40 (CRS/CRS_DV/LED_CFG); also elsewhere on the board
/PHY2/MDC: U1002.31 (MDC); also elsewhere on the board
/PHY2/MDIO: U1002.30 (MDIO); also elsewhere on the board
/PHY2/MDIX_EN: U1002.41 (RX_ER/MDIX_EN)
/PHY2/PHY_AD0: U1002.42 (COL/PHY_AD0)
/PHY2/PHY_AD3: U1002.45 (RXD_2/PHY_AD3)
/PHY2/PHY_AD4: U1002.46 (RXD_3/PHY_AD4)
/PHY2/RX+: J1001.R3 (RD+), R1003.2, U1002.14 (RD+)
/PHY2/RX-: J1001.R6 (RD-), R1008.2, U1002.13 (RD-)
/PHY2/SNI_MODE: U1002.6 (TXD_3/SNI_MODE)
/PHY2/TD+: J1001.R1 (TD+), R1002.2, U1002.17 (TD+)
/PHY2/TD-: J1001.R2 (TD-), R1007.2, U1002.16 (TD-)
/PHY3/AN0: D801.1 (K), J801.L3 (LEDG_K), U802.28 (AN0/LED_LINK)
/PHY3/AN1: D802.1 (K), J801.L2 (LEDY_K), U802.27 (AN1/LED_SPEED)
/PHY3/AN_EN: D803.1 (K), U802.26 (AN_EN/LED_ACT/COL)
/PHY3/CLK_OUT: U802.25 (25M_OUT); also elsewhere on the board
/PHY3/CLK_X1: U802.34 (X1); also elsewhere on the board
/PHY3/CLK_X2: U802.33 (X2)
/PHY3/CRS_DV: U802.40 (CRS/CRS_DV/LED_CFG); also elsewhere on the board
/PHY3/MDC: U802.31 (MDC); also elsewhere on the board
/PHY3/MDIO: U802.30 (MDIO); also elsewhere on the board
/PHY3/MDIX_EN: U802.41 (RX_ER/MDIX_EN)
/PHY3/PHY_3V3: C801.1, C803.1, C804.1, C805.1, C806.1, FB801.1, R801.1, R804.1, R805.1, R812.2, R813.2, R814.1, R815.1, R816.1, U801.2 (VO), U802.22 (AVDD33), U802.32 (IOVDD33), U802.48 (IOVDD33)
/PHY3/PHY_AD0: U802.42 (COL/PHY_AD0)
/PHY3/PHY_AD3: U802.45 (RXD_2/PHY_AD3)
/PHY3/PHY_AD4: U802.46 (RXD_3/PHY_AD4)
/PHY3/RX+: J801.R3 (RD+), R803.2, U802.14 (RD+)
/PHY3/RX-: J801.R6 (RD-), R808.2, U802.13 (RD-)
/PHY3/SNI_MODE: U802.6 (TXD_3/SNI_MODE)
/PHY3/TD+: J801.R1 (TD+), R802.2, U802.17 (TD+)
/PHY3/TD-: J801.R2 (TD-), R807.2, U802.16 (TD-)
GNDD: C701.2, C703.2, C704.2, C801.2, C802.2, C803.2, C804.2, C805.2, C806.2, C807.2, C808.2, C809.1, C810.2, C811.2, C1002.2, C1005.2, C1006.2, C1007.2, C1008.2, C1009.1, C1010.2, C1011.2, C1101.2, C1102.2, C1103.2, C1104.2, C1105.2, C1106.2, C1107.2, C1108.2, C1109.1, C1110.2, C1111.2, J801.R8 (GND), J1001.R8 (GND), J1101.R8 (GND), R811.1, R1011.1, R1111.1, U801.1 (GND), U802.15 (AGND), U802.19 (AGND), U802.35 (IOGND), U802.36 (DGND), U802.47 (IOGND), U1001.1 (GND), U1002.15 (AGND), U1002.19 (AGND), U1002.35 (IOGND), U1002.36 (DGND), U1002.47 (IOGND), U1101.1 (GND), U1102.15 (AGND), U1102.19 (AGND), U1102.35 (IOGND), U1102.36 (DGND), U1102.47 (IOGND); also elsewhere on the board
unnamed: C807.1, U802.37 (PFBIN2)
unnamed: C808.1, U802.18 (PFBIN1)
unnamed: C809.2, FB801.2, J801.R4 (TCT), J801.R5 (RCT), R802.1, R803.1, R807.1, R808.1
unnamed: C810.1, C811.1, U802.23 (PFBOUT)
unnamed: C1007.1, U1002.37 (PFBIN2)
unnamed: C1008.1, U1002.18 (PFBIN1)
unnamed: C1009.2, FB1001.2, J1001.R4 (TCT), J1001.R5 (RCT), R1002.1, R1003.1, R1007.1, R1008.1
unnamed: C1010.1, C1011.1, U1002.23 (PFBOUT)
unnamed: C1107.1, U1102.37 (PFBIN2)
unnamed: C1108.1, U1102.18 (PFBIN1)
unnamed: C1109.2, FB1101.2, J1101.R4 (TCT), J1101.R5 (RCT), R1102.1, R1103.1, R1107.1, R1108.1
unnamed: C1110.1, C1111.1, U1102.23 (PFBOUT)
unnamed: D801.2 (A), R814.2
unnamed: D802.2 (A), R815.2
unnamed: D803.2 (A), R816.2
unnamed: D1001.2 (A), R1014.2
unnamed: D1002.2 (A), R1015.2
unnamed: D1003.2 (A), R1016.2
unnamed: D1101.2 (A), R1114.2
unnamed: D1102.2 (A), R1115.2
unnamed: D1103.2 (A), R1116.2
unnamed: J801.L1 (LEDY_A), R813.1
unnamed: J801.L4 (LEDG_A), R812.1
unnamed: J1001.L1 (LEDY_A), R1013.1
unnamed: J1001.L4 (LEDG_A), R1012.1
unnamed: J1101.L1 (LEDY_A), R1113.1
unnamed: J1101.L4 (LEDG_A), R1112.1
unnamed: R804.2, U802.20 (RESERVED)
unnamed: R805.2, U802.21 (RESERVED)
unnamed: R806.1, R809.2
unnamed: R806.2, U802.24 (RBIAS)
unnamed: R809.1, R810.2
unnamed: R810.1, R811.2
unnamed: R1004.2, U1002.20 (RESERVED)
unnamed: R1005.2, U1002.21 (RESERVED)
unnamed: R1006.1, R1009.2
unnamed: R1006.2, U1002.24 (RBIAS)
unnamed: R1009.1, R1010.2
unnamed: R1010.1, R1011.2
unnamed: R1104.2, U1102.20 (RESERVED)
unnamed: R1105.2, U1102.21 (RESERVED)
unnamed: R1106.1, R1109.2
unnamed: R1106.2, U1102.24 (RBIAS)
unnamed: R1109.1, R1110.2
unnamed: R1110.1, R1111.2

Notes on the sheet:
Bootstrapping Options
Local PHY Power Supply
Decoupling
4k87 0402
