TheGreatChris/ethernet-sniffer/ethernet-sniffer.kicad_pcb

## KiCad design ethernet-sniffer.kicad_pcb (continued)

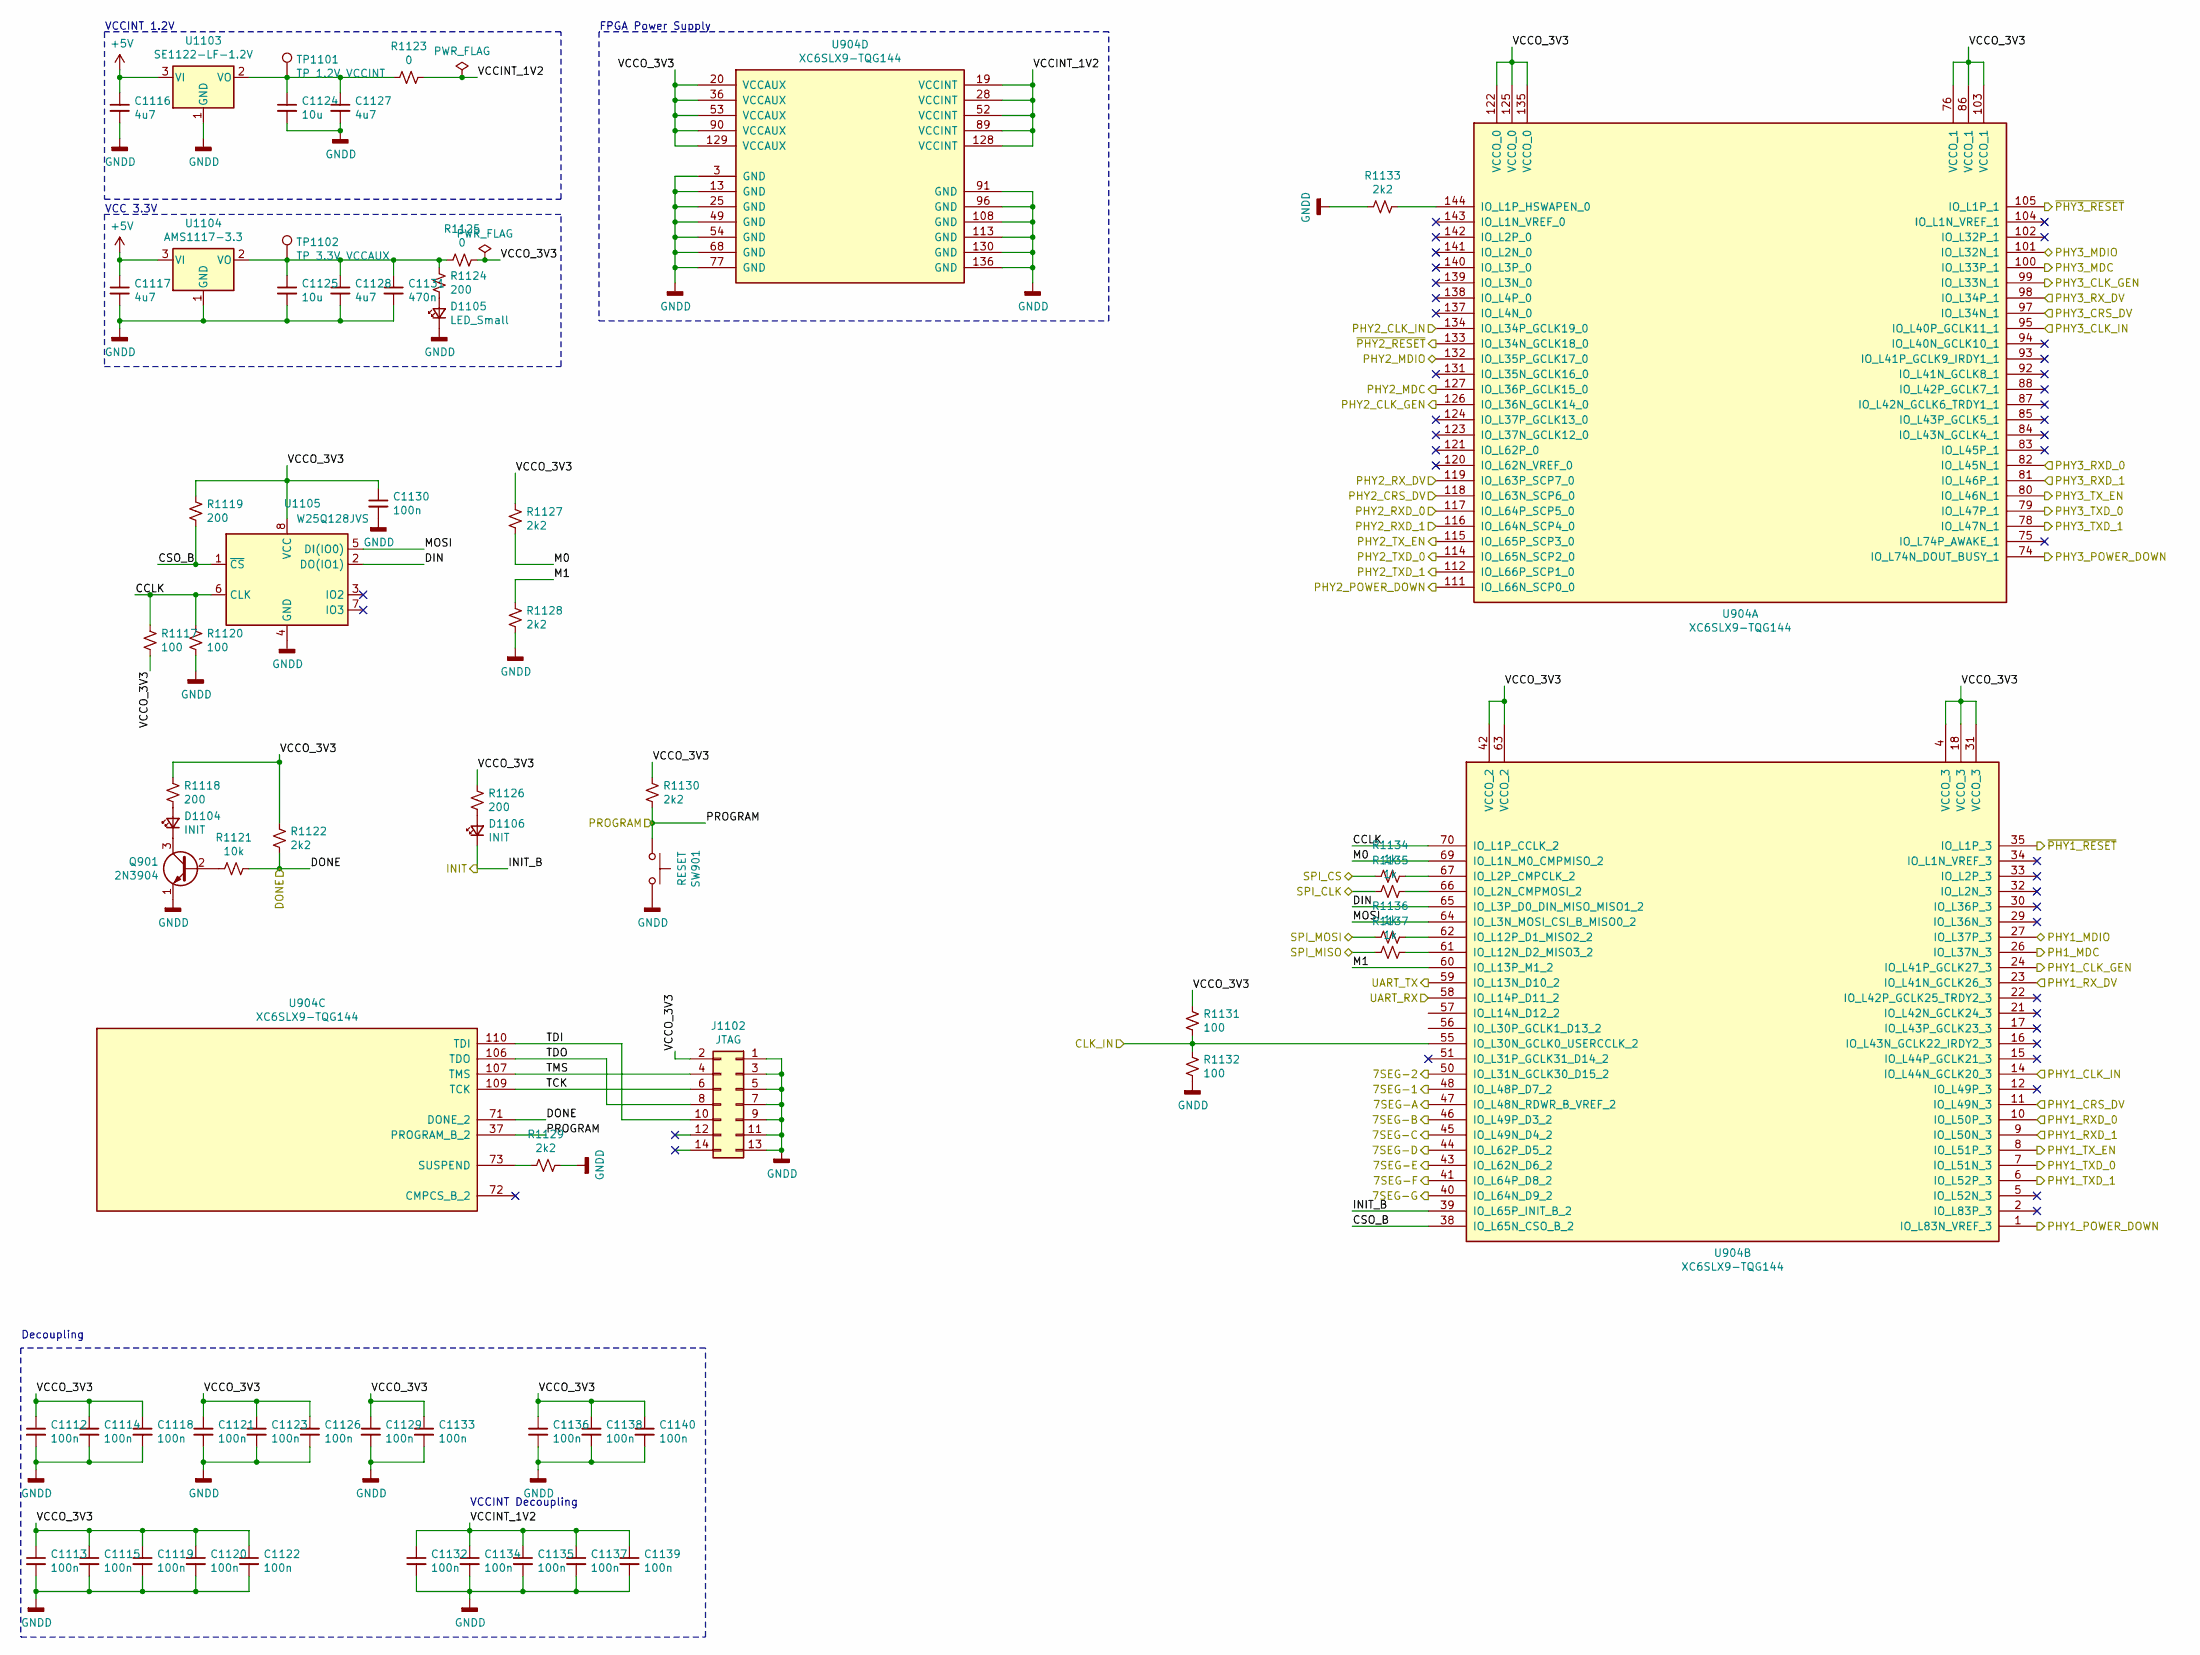
[picture p16: schematic FPGA_LDO.sch]

Parts:
C1112, C1113, C1114, C1115, C1118, C1119, C1120, C1121, C1122, C1123, C1126, C1129, C1130, C1132, C1133, C1134, C1135, C1136, C1137, C1138, C1139, C1140: 100n; C_0402_1005Metric
C1116, C1117, C1127, C1128: 4u7; C_0402_1005Metric
C1124, C1125: 10u; C_0402_1005Metric
C1131: 470n; C_0402_1005Metric
D1104, D1106: INIT; LED_0603_1608Metric
D1105: LED_Small; LED_0603_1608Metric
J1102: JTAG; PinHeader_2x07_P2.54mm_Vertical
Q901: 2N3904; SOT-23
R1117, R1120, R1131, R1132: 100; R_0402_1005Metric
R1118, R1119, R1124, R1126: 200; R_0402_1005Metric
R1121: 10k; R_0402_1005Metric
R1122, R1127, R1128, R1129, R1130, R1133: 2k2; R_0402_1005Metric
R1123, R1125: 0; R_0402_1005Metric
R1134, R1135, R1136, R1137: 1k; R_0402_1005Metric
SW901: RESET; SW_Push_SPST_NO_Alps_SKRK
TP1101: TP 1.2V VCCINT; TestPoint_Pad_D1.0mm
TP1102: TP 3.3V VCCAUX; TestPoint_Pad_D1.0mm
U904: XC6SLX9-TQG144; LQFP-144_20x20mm_P0.5mm
U1103: SE1122-LF-1.2V; SOT-223-3_TabPin2
U1104: AMS1117-3.3; SOT-223-3_TabPin2
U1105: W25Q128JVS; SOIC-8_5.23x5.23mm_P1.27mm

Connections:
+5V: C1116.1, C1117.1, U1103.3 (VI), U1104.3 (VI); also elsewhere on the board
/7seg-display/7SEG-1: U904.48 (IO_L48P_D7_2); also elsewhere on the board
/7seg-display/7SEG-2: U904.50 (IO_L31N_GCLK30_D15_2); also elsewhere on the board
/7seg-display/7SEG-A: U904.47 (IO_L48N_RDWR_B_VREF_2); also elsewhere on the board
/7seg-display/7SEG-B: U904.46 (IO_L49P_D3_2); also elsewhere on the board
/7seg-display/7SEG-C: U904.45 (IO_L49N_D4_2); also elsewhere on the board
/7seg-display/7SEG-D: U904.44 (IO_L62P_D5_2); also elsewhere on the board
/7seg-display/7SEG-E: U904.43 (IO_L62N_D6_2); also elsewhere on the board
/7seg-display/7SEG-F: U904.41 (IO_L64P_D8_2); also elsewhere on the board
/7seg-display/7SEG-G: U904.40 (IO_L64N_D9_2); also elsewhere on the board
/FPGA/CCLK: R1117.1, R1120.1, U904.70 (IO_L1P_CCLK_2), U1105.6 (CLK)
/FPGA/CLK_IN: R1131.2, R1132.1, U904.55 (IO_L30N_GCLK0_USERCCLK_2); also elsewhere on the board
/FPGA/CSO_B: R1119.2, U904.38 (IO_L65N_CSO_B_2), U1105.1 (~CS)
/FPGA/DIN: U904.65 (IO_L3P_D0_DIN_MISO_MISO1_2), U1105.2 (DO(IO1))
/FPGA/DONE: R1121.1, R1122.2, U904.71 (DONE_2); also elsewhere on the board
/FPGA/M0: R1127.2, U904.69 (IO_L1N_M0_CMPMISO_2)
/FPGA/M1: R1128.1, U904.60 (IO_L13P_M1_2)
/FPGA/MOSI: U904.64 (IO_L3N_MOSI_CSI_B_MISO0_2), U1105.5 (DI(IO0))
/FPGA/PHY1_POWER_DOWN: U904.1 (IO_L83N_VREF_3); also elsewhere on the board
/FPGA/PHY1_RXD_0: U904.10 (IO_L50P_3); also elsewhere on the board
/FPGA/PHY1_RXD_1: U904.9 (IO_L50N_3); also elsewhere on the board
/FPGA/PHY1_RX_DV: U904.23 (IO_L41N_GCLK26_3); also elsewhere on the board
/FPGA/PHY1_TXD_0: U904.7 (IO_L51N_3); also elsewhere on the board
/FPGA/PHY1_TXD_1: U904.6 (IO_L52P_3); also elsewhere on the board
/FPGA/PHY1_TX_EN: U904.8 (IO_L51P_3); also elsewhere on the board
/FPGA/PHY2_POWER_DOWN: U904.111 (IO_L66N_SCP0_0); also elsewhere on the board
/FPGA/PHY2_RXD_0: U904.117 (IO_L64P_SCP5_0); also elsewhere on the board
/FPGA/PHY2_RXD_1: U904.116 (IO_L64N_SCP4_0); also elsewhere on the board
/FPGA/PHY2_RX_DV: U904.119 (IO_L63P_SCP7_0); also elsewhere on the board
/FPGA/PHY2_TXD_0: U904.114 (IO_L65N_SCP2_0); also elsewhere on the board
/FPGA/PHY2_TXD_1: U904.112 (IO_L66P_SCP1_0); also elsewhere on the board
/FPGA/PHY2_TX_EN: U904.115 (IO_L65P_SCP3_0); also elsewhere on the board
/FPGA/PHY3_POWER_DOWN: U904.74 (IO_L74N_DOUT_BUSY_1); also elsewhere on the board
/FPGA/PHY3_RXD_0: U904.82 (IO_L45N_1); also elsewhere on the board
/FPGA/PHY3_RXD_1: U904.81 (IO_L46P_1); also elsewhere on the board
/FPGA/PHY3_RX_DV: U904.98 (IO_L34P_1); also elsewhere on the board
/FPGA/PHY3_TXD_0: U904.79 (IO_L47P_1); also elsewhere on the board
/FPGA/PHY3_TXD_1: U904.78 (IO_L47N_1); also elsewhere on the board
/FPGA/PHY3_TX_EN: U904.80 (IO_L46N_1); also elsewhere on the board
/FPGA/TCK: J1102.6, U904.109 (TCK)
/FPGA/TDI: J1102.10, U904.110 (TDI)
/FPGA/TDO: J1102.8, U904.106 (TDO)
/FPGA/TMS: J1102.4, U904.107 (TMS)
/FPGA/VCCINT_1V2: C1132.1, C1134.1, C1135.1, C1137.1, C1139.1, R1123.1, U904.19 (VCCINT), U904.28 (VCCINT), U904.52 (VCCINT), U904.89 (VCCINT), U904.128 (VCCINT)
/FPGA/VCCO_3V3: C1112.1, C1113.1, C1114.1, C1115.1, C1118.1, C1119.1, C1120.1, C1121.1, C1122.1, C1123.1, C1126.1, C1129.1, C1130.1, C1133.1, C1136.1, C1138.1, C1140.1, J1102.2, R1117.2, R1118.1, R1119.1, R1122.1, R1125.1, R1126.1, R1127.1, R1130.1, R1131.1, U904.4 (VCCO_3), U904.18 (VCCO_3), U904.20 (VCCAUX), U904.31 (VCCO_3), U904.36 (VCCAUX), U904.42 (VCCO_2), U904.53 (VCCAUX), U904.63 (VCCO_2), U904.76 (VCCO_1), U904.86 (VCCO_1), U904.90 (VCCAUX), U904.103 (VCCO_1), U904.122 (VCCO_0), U904.125 (VCCO_0), U904.129 (VCCAUX), U904.135 (VCCO_0), U1105.8 (VCC)
/FPGA/~PHY1_RESET: U904.35 (IO_L1P_3); also elsewhere on the board
/FPGA/~PHY2_RESET: U904.133 (IO_L34N_GCLK18_0); also elsewhere on the board
/FPGA/~PHY3_RESET: U904.105 (IO_L1P_1); also elsewhere on the board
/PHY1/CLK_OUT: U904.14 (IO_L44N_GCLK20_3); also elsewhere on the board
/PHY1/CLK_X1: U904.24 (IO_L41P_GCLK27_3); also elsewhere on the board
/PHY1/CRS_DV: U904.11 (IO_L49N_3); also elsewhere on the board
/PHY1/MDC: U904.26 (IO_L37N_3); also elsewhere on the board
/PHY1/MDIO: U904.27 (IO_L37P_3); also elsewhere on the board
/PHY2/CLK_OUT: U904.134 (IO_L34P_GCLK19_0); also elsewhere on the board
/PHY2/CLK_X1: U904.126 (IO_L36N_GCLK14_0); also elsewhere on the board
/PHY2/CRS_DV: U904.118 (IO_L63N_SCP6_0); also elsewhere on the board
/PHY2/MDC: U904.127 (IO_L36P_GCLK15_0); also elsewhere on the board
/PHY2/MDIO: U904.132 (IO_L35P_GCLK17_0); also elsewhere on the board
/PHY3/CLK_OUT: U904.95 (IO_L40P_GCLK11_1); also elsewhere on the board
/PHY3/CLK_X1: U904.99 (IO_L33N_1); also elsewhere on the board
/PHY3/CRS_DV: U904.97 (IO_L34N_1); also elsewhere on the board
/PHY3/MDC: U904.100 (IO_L33P_1); also elsewhere on the board
/PHY3/MDIO: U904.101 (IO_L32N_1); also elsewhere on the board
/STM32/FPGA_INIT: D1106.1 (K), U904.39 (IO_L65P_INIT_B_2); also elsewhere on the board
/STM32/FPGA_PROGRAM: R1130.2, SW901.1, U904.37 (PROGRAM_B_2); also elsewhere on the board
/STM32/SPI1_CS: R1134.2; also elsewhere on the board
/STM32/SPI1_MISO: R1136.2; also elsewhere on the board
/STM32/SPI1_MOSI: R1137.2; also elsewhere on the board
/STM32/SPI1_SCK: R1135.2; also elsewhere on the board
/USB-UART/UART-RX: U904.59 (IO_L13N_D10_2); also elsewhere on the board
/USB-UART/UART-TX: U904.58 (IO_L14P_D11_2); also elsewhere on the board
GNDD: C1112.2, C1113.2, C1114.2, C1115.2, C1116.2, C1117.2, C1118.2, C1119.2, C1120.2, C1121.2, C1122.2, C1123.2, C1124.2, C1125.2, C1126.2, C1127.2, C1128.2, C1129.2, C1130.2, C1131.2, C1132.2, C1133.2, C1134.2, C1135.2, C1136.2, C1137.2, C1138.2, C1139.2, C1140.2, D1105.1 (K), J1102.1, J1102.3, J1102.5, J1102.7, J1102.9, J1102.11, J1102.13, Q901.1 (E), R1120.2, R1128.2, R1129.1, R1132.2, R1133.2, SW901.2, U904.3 (GND), U904.13 (GND), U904.25 (GND), U904.49 (GND), U904.54 (GND), U904.68 (GND), U904.77 (GND), U904.91 (GND), U904.96 (GND), U904.108 (GND), U904.113 (GND), U904.130 (GND), U904.136 (GND), U1103.1 (GND), U1104.1 (GND), U1105.4 (GND); also elsewhere on the board
unnamed: C1124.1, C1127.1, R1123.2, TP1101.1, U1103.2 (VO)
unnamed: C1125.1, C1128.1, C1131.1, R1124.1, R1125.2, TP1102.1, U1104.2 (VO)
unnamed: D1104.1 (K), Q901.3 (C)
unnamed: D1104.2 (A), R1118.2
unnamed: D1105.2 (A), R1124.2
unnamed: D1106.2 (A), R1126.2
unnamed: Q901.2 (B), R1121.2
unnamed: R1129.2, U904.73 (SUSPEND)
unnamed: R1133.1, U904.144 (IO_L1P_HSWAPEN_0)
unnamed: R1134.1, U904.67 (IO_L2P_CMPCLK_2)
unnamed: R1135.1, U904.66 (IO_L2N_CMPMOSI_2)
unnamed: R1136.1, U904.62 (IO_L12P_D1_MISO2_2)
unnamed: R1137.1, U904.61 (IO_L12N_D2_MISO3_2)

Notes on the sheet:
Decoupling
VCCINT 1.2V
VCC 3.3V
VCCINT Decoupling
FPGA Power Supply

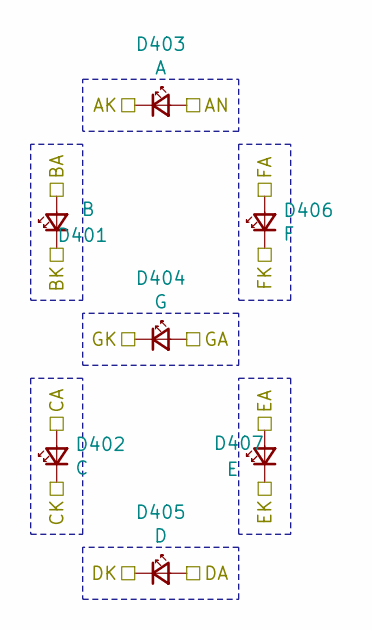
[picture p17: schematic 7segment.sch]

Parts:
D301: B; LED_0603_1608Metric
D302: C; LED_0603_1608Metric
D303: A; LED_0603_1608Metric
D304: G; LED_0603_1608Metric
D305: D; LED_0603_1608Metric
D306: F; LED_0603_1608Metric
D307: E; LED_0603_1608Metric

Connections:
/7seg-display/Digit 1/AK: D301.1 (K), D302.1 (K), D303.1 (K), D304.1 (K), D305.1 (K), D306.1 (K), D307.1 (K); also elsewhere on the board
/7seg-display/Digit 1/AN: D303.2 (A); also elsewhere on the board
/7seg-display/Digit 1/BA: D301.2 (A); also elsewhere on the board
/7seg-display/Digit 1/CA: D302.2 (A); also elsewhere on the board
/7seg-display/Digit 1/DA: D305.2 (A); also elsewhere on the board
/7seg-display/Digit 1/EA: D307.2 (A); also elsewhere on the board
/7seg-display/Digit 1/FA: D306.2 (A); also elsewhere on the board
/7seg-display/Digit 1/GA: D304.2 (A); also elsewhere on the board

Parts of its further copies:
D401: B; LED_0603_1608Metric
D402: C; LED_0603_1608Metric
D403: A; LED_0603_1608Metric
D404: G; LED_0603_1608Metric
D405: D; LED_0603_1608Metric
D406: F; LED_0603_1608Metric
D407: E; LED_0603_1608Metric

Connections of its further copies:
/7seg-display/Digit 1/AN: D403.2 (A); also elsewhere on the board
/7seg-display/Digit 1/BA: D401.2 (A); also elsewhere on the board
/7seg-display/Digit 1/CA: D402.2 (A); also elsewhere on the board
/7seg-display/Digit 1/DA: D405.2 (A); also elsewhere on the board
/7seg-display/Digit 1/EA: D407.2 (A); also elsewhere on the board
/7seg-display/Digit 1/FA: D406.2 (A); also elsewhere on the board
/7seg-display/Digit 1/GA: D404.2 (A); also elsewhere on the board
/7seg-display/Digit 2/AK: D401.1 (K), D402.1 (K), D403.1 (K), D404.1 (K), D405.1 (K), D406.1 (K), D407.1 (K); also elsewhere on the board

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
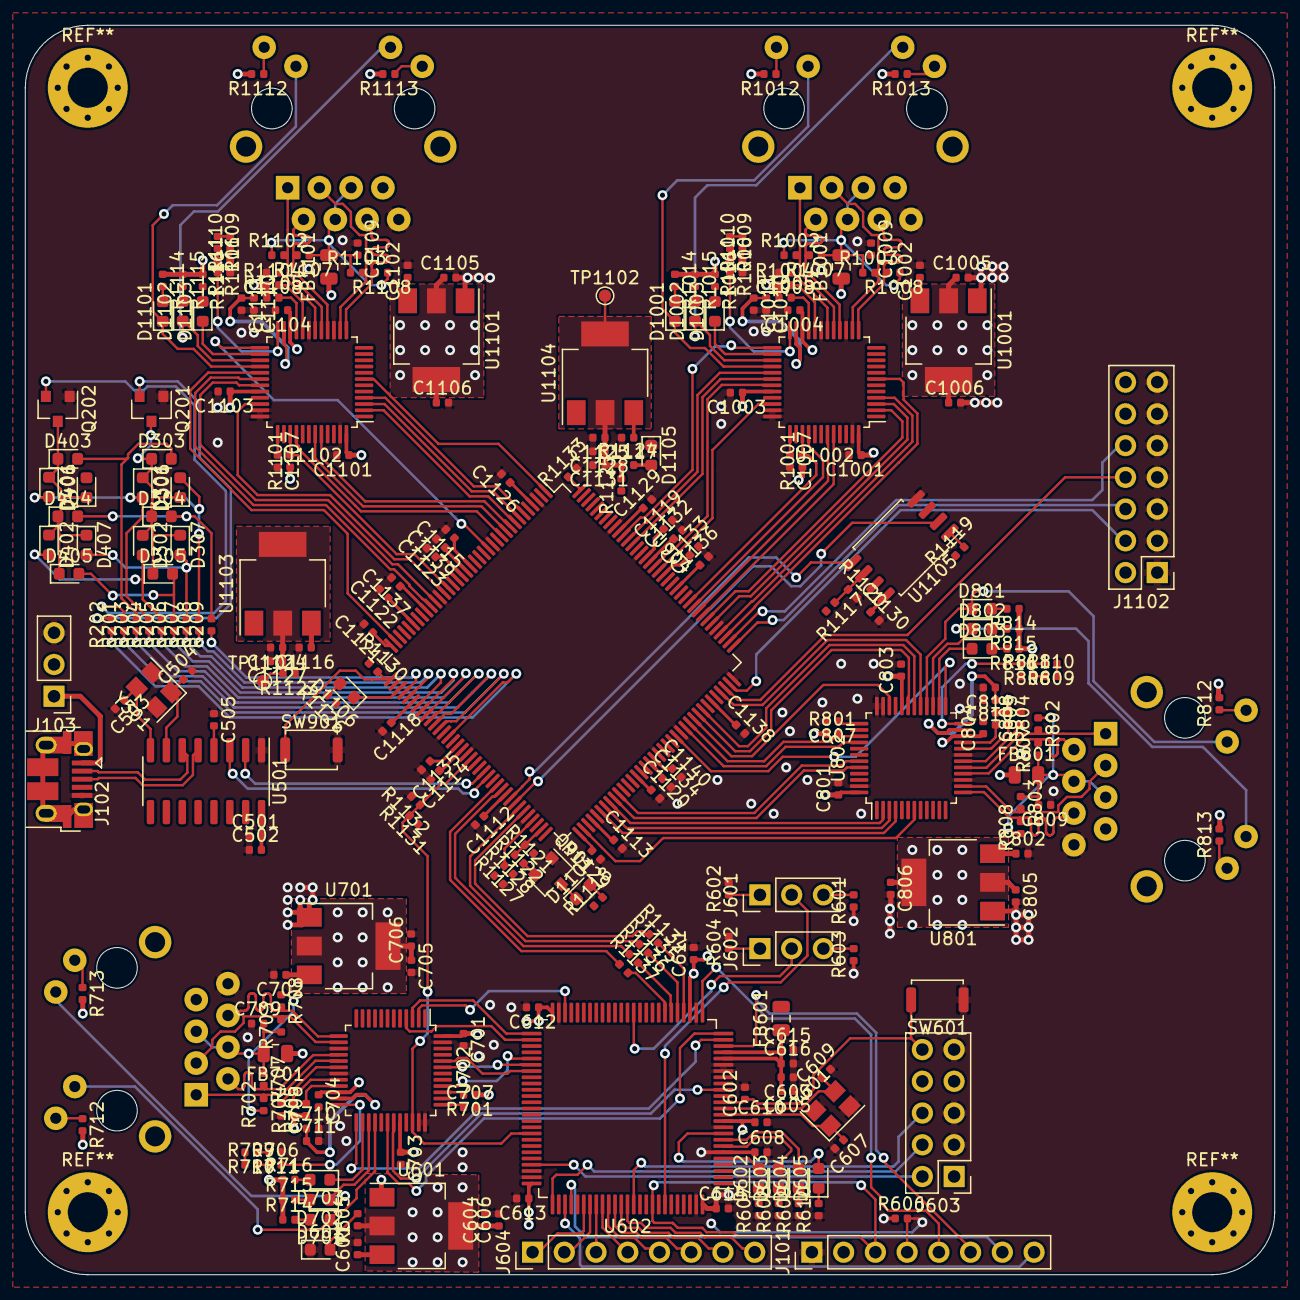
[picture p18: board ethernet-sniffer.kicad_pcb from above]

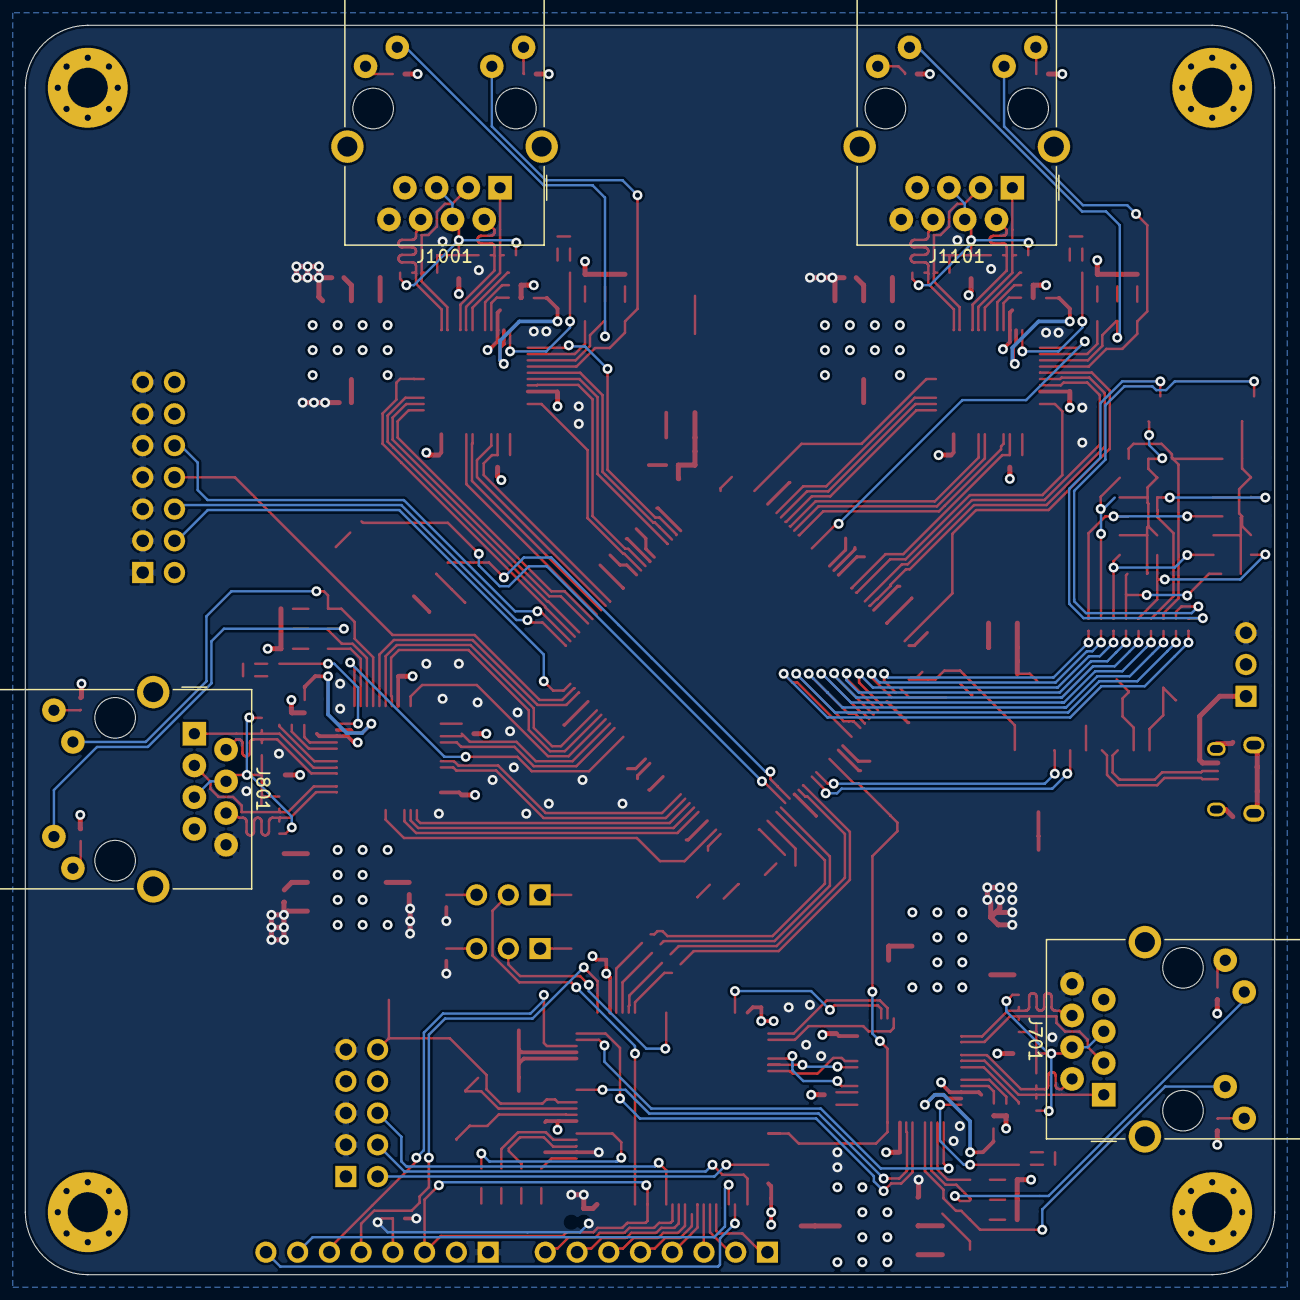
[picture p19: board ethernet-sniffer.kicad_pcb from below]

Board: 4 copper layers, 100.0 x 100.0 mm, 273 parts (4 on the bottom side), 241 nets.
