TheGreatChris/ethernet-sniffer/ethernet-sniffer/ethernet-sniffer.kicad_pcb

## KiCad design ethernet-sniffer/ethernet-sniffer.kicad_pcb (2020-06-16)

Schematic: ethernet-sniffer.sch

Parts:
J101: Conn_01x06; PinHeader_1x06_P2.54mm_Vertical
J102: USB_B_Micro; USB_Micro-B_Amphenol_10103594-0001LF_Horizontal
J103: POWER 5V; PinHeader_1x03_P2.54mm_Vertical

Connections:
+5V: J103.2; also elsewhere on the board
/STM32/ADC1: J101.3; also elsewhere on the board
/STM32/ADC2: J101.4; also elsewhere on the board
/STM32/I2C_SCL: J101.6; also elsewhere on the board
/STM32/I2C_SDA: J101.5; also elsewhere on the board
/STM32/UART_RX: J101.2; also elsewhere on the board
/STM32/UART_TX: J101.1; also elsewhere on the board
/USB-UART/USB-D+: J102.3 (D+); also elsewhere on the board
/USB-UART/USB-D-: J102.2 (D-); also elsewhere on the board
GNDD: J102.5 (GND), J103.3; also elsewhere on the board
unnamed: J102.1 (VBUS), J103.1


Parts:
Q201, Q202: 2N3904; SOT-23
R201, R202: 1k; R_0402_1005Metric
R203, R204, R205, R206, R207, R208, R209: 200; R_0402_1005Metric

Connections:
/7seg-display/7SEG-1: R201.1; also elsewhere on the board
/7seg-display/7SEG-2: R202.1; also elsewhere on the board
/7seg-display/7SEG-A: R203.1; also elsewhere on the board
/7seg-display/7SEG-B: R204.1; also elsewhere on the board
/7seg-display/7SEG-C: R205.1; also elsewhere on the board
/7seg-display/7SEG-D: R206.1; also elsewhere on the board
/7seg-display/7SEG-E: R207.1; also elsewhere on the board
/7seg-display/7SEG-F: R208.1; also elsewhere on the board
/7seg-display/7SEG-G: R209.1; also elsewhere on the board
/7seg-display/Digit 1/AK: Q201.3 (C); also elsewhere on the board
/7seg-display/Digit 1/AN: R203.2; also elsewhere on the board
/7seg-display/Digit 1/BA: R204.2; also elsewhere on the board
/7seg-display/Digit 1/CA: R205.2; also elsewhere on the board
/7seg-display/Digit 1/DA: R206.2; also elsewhere on the board
/7seg-display/Digit 1/EA: R207.2; also elsewhere on the board
/7seg-display/Digit 1/FA: R208.2; also elsewhere on the board
/7seg-display/Digit 1/GA: R209.2; also elsewhere on the board
/7seg-display/Digit 2/AK: Q202.3 (C); also elsewhere on the board
GNDD: Q201.1 (E), Q202.1 (E); also elsewhere on the board
unnamed: Q201.2 (B), R202.2
unnamed: Q202.2 (B), R201.2

Notes on the sheet:
7-Segment Display

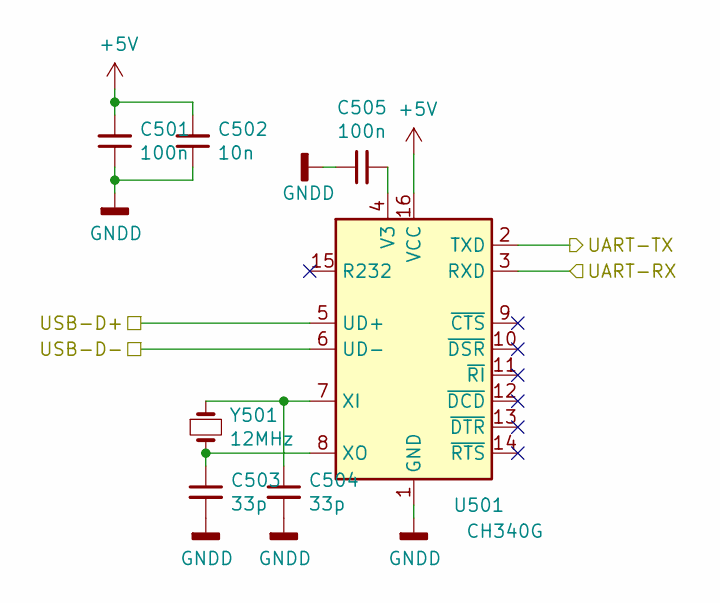
[picture p20: schematic USBUART.sch]

Parts:
C501, C505: 100n; C_0402_1005Metric
C502: 10n; C_0402_1005Metric
C503, C504: 33p; C_0402_1005Metric
U501: CH340G; SOIC-16_3.9x9.9mm_P1.27mm
Y501: 12MHz; Crystal_SMD_0603-2Pin_6.0x3.5mm

Connections:
+5V: C501.2, C502.2, U501.16 (VCC); also elsewhere on the board
/USB-UART/UART-RX: U501.3 (RXD); also elsewhere on the board
/USB-UART/UART-TX: U501.2 (TXD); also elsewhere on the board
/USB-UART/USB-D+: U501.5 (UD+); also elsewhere on the board
/USB-UART/USB-D-: U501.6 (UD-); also elsewhere on the board
GNDD: C501.1, C502.1, C503.2, C504.2, C505.1, U501.1 (GND); also elsewhere on the board
unnamed: C503.1, U501.8 (XO), Y501.2
unnamed: C504.1, U501.7 (XI), Y501.1
unnamed: C505.2, U501.4 (V3)

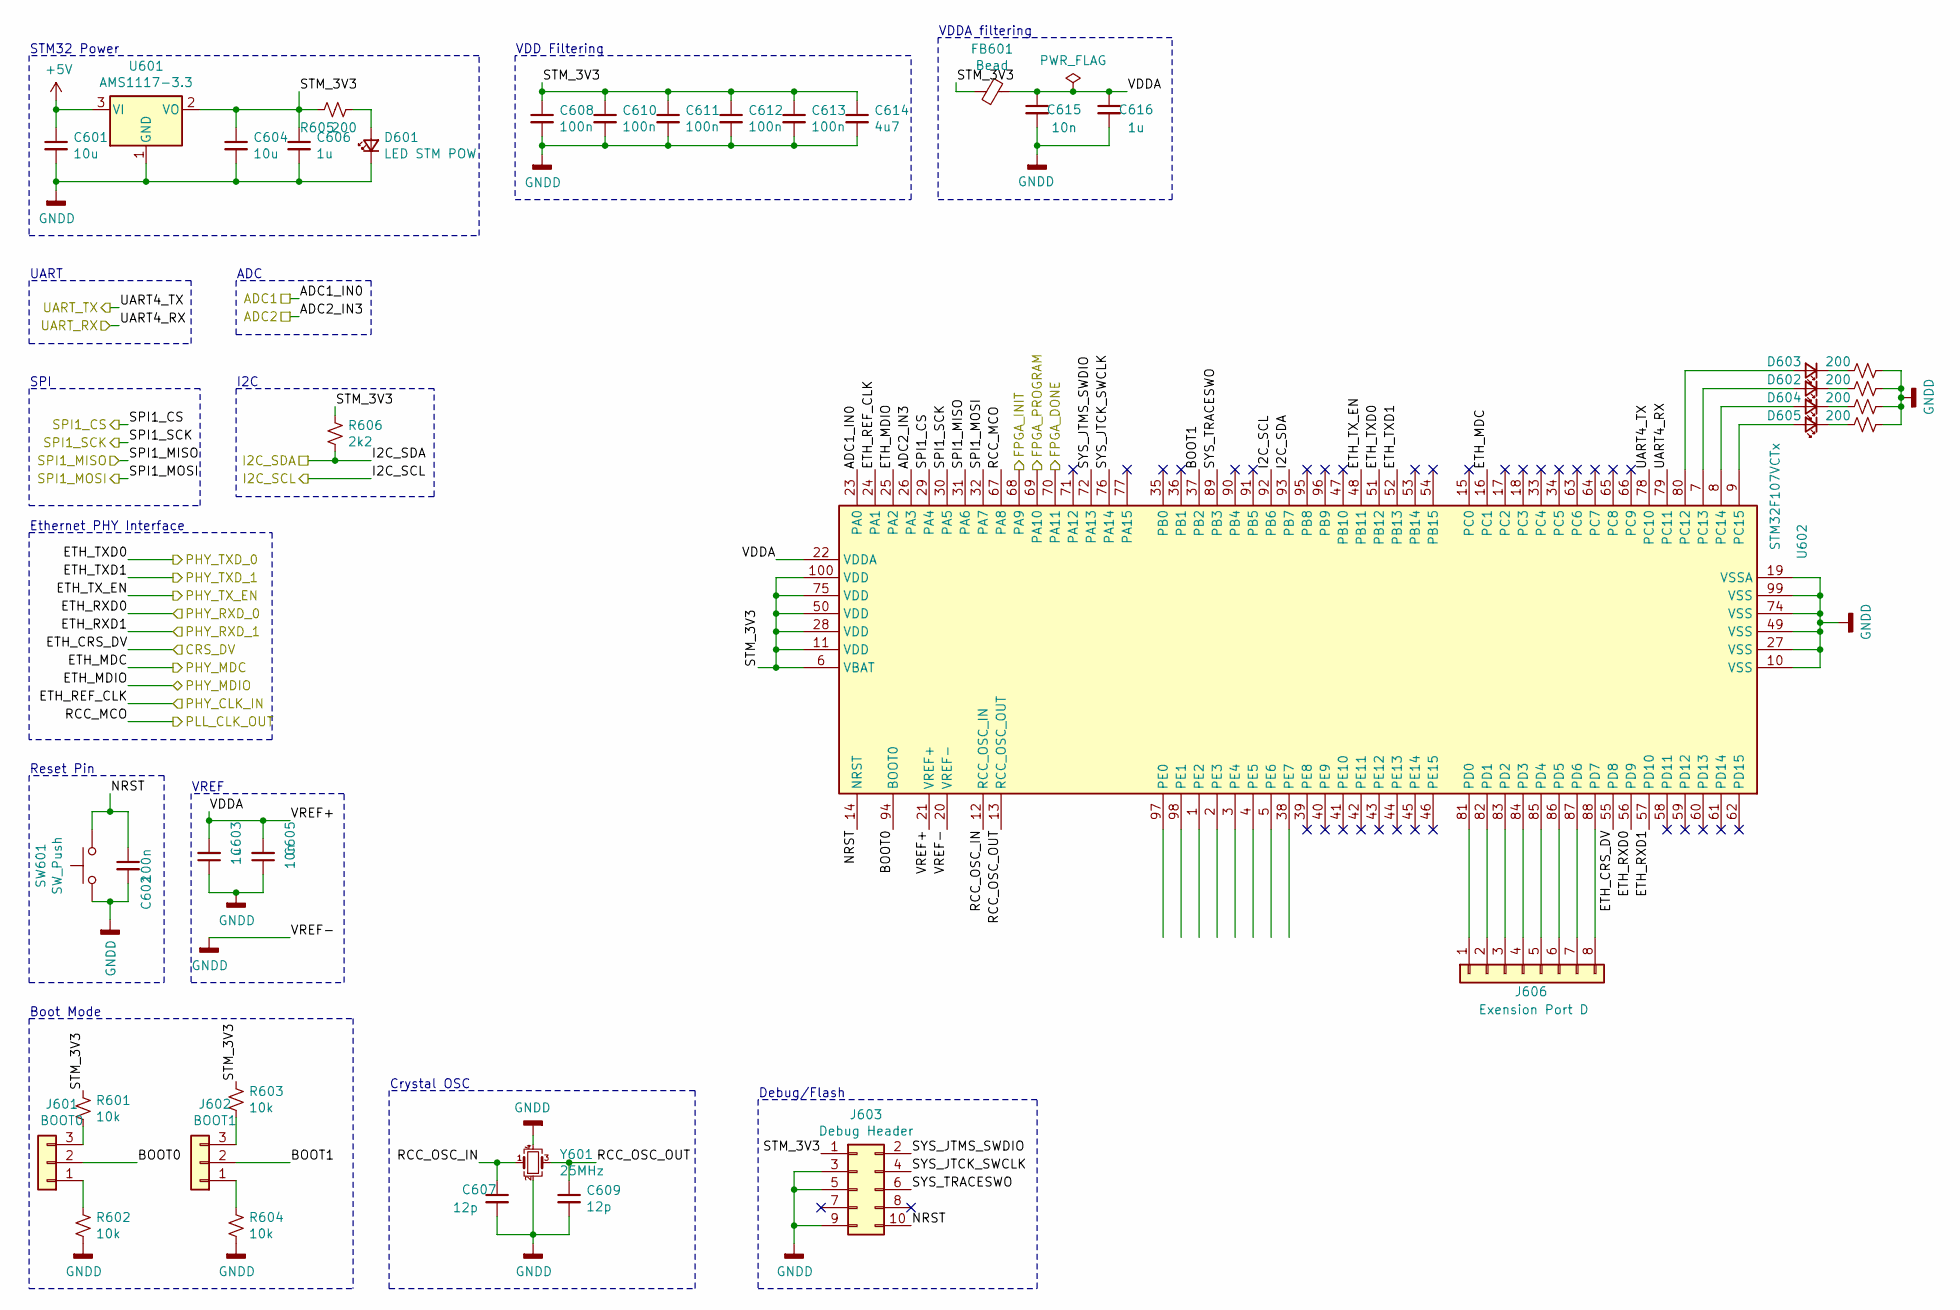
[picture p21: schematic stm32.sch]

Parts:
C601, C604: 10u; C_0402_1005Metric
C602, C608, C610, C611, C612, C613: 100n; C_0402_1005Metric
C603, C606, C616: 1u; C_0402_1005Metric
C605, C615: 10n; C_0402_1005Metric
C607, C609: 12p; C_0402_1005Metric
C614: 4u7; C_0402_1005Metric
D601: LED STM POW; LED_0603_1608Metric
D602, D603, D604, D605: LED_Small; LED_0603_1608Metric
FB601: Bead; L_0805_2012Metric
J601: BOOT0; PinHeader_1x03_P2.54mm_Vertical
J602: BOOT1; PinHeader_1x03_P2.54mm_Vertical
J603: Debug Header; PinHeader_2x05_P2.54mm_Vertical
J606: Exension Port D; PinHeader_1x08_P2.54mm_Vertical
R601, R602, R603, R604: 10k; R_0402_1005Metric
R605, R607, R608, R609, R610: 200; R_0402_1005Metric
R606: 2k2; R_0402_1005Metric
SW601: SW_Push; SW_Push_SPST_NO_Alps_SKRK
U601: AMS1117-3.3; SOT-223-3_TabPin2
U602: STM32F107VCTx; LQFP-100_14x14mm_P0.5mm
Y601: 25MHz; Crystal_SMD_5032-4Pin_5.0x3.2mm

Connections:
+5V: C601.1, U601.3 (VI); also elsewhere on the board
/100BASETX-PHY 1/CLK_OUT: U602.24 (PA1); also elsewhere on the board
/100BASETX-PHY 1/CRS_DV: U602.55 (PD8); also elsewhere on the board
/100BASETX-PHY 1/MDC: U602.16 (PC1); also elsewhere on the board
/100BASETX-PHY 1/MDIO: U602.25 (PA2); also elsewhere on the board
/FPGA/CLK_IN: U602.67 (PA8); also elsewhere on the board
/FPGA/DONE: U602.70 (PA11); also elsewhere on the board
/STM32/ADC1: U602.23 (PA0); also elsewhere on the board
/STM32/ADC2: U602.26 (PA3); also elsewhere on the board
/STM32/BOOT0: J601.2, U602.94 (BOOT0)
/STM32/BOOT1: J602.2, U602.37 (PB2)
/STM32/FPGA_INIT: U602.68 (PA9); also elsewhere on the board
/STM32/FPGA_PROGRAM: U602.69 (PA10); also elsewhere on the board
/STM32/I2C_SCL: U602.92 (PB6); also elsewhere on the board
/STM32/I2C_SDA: R606.2, U602.93 (PB7); also elsewhere on the board
/STM32/NRST: C602.1, J603.10, SW601.2, U602.14 (NRST)
/STM32/PHY_RXD_0: U602.56 (PD9); also elsewhere on the board
/STM32/PHY_RXD_1: U602.57 (PD10); also elsewhere on the board
/STM32/PHY_TXD_0: U602.51 (PB12); also elsewhere on the board
/STM32/PHY_TXD_1: U602.52 (PB13); also elsewhere on the board
/STM32/PHY_TX_EN: U602.48 (PB11); also elsewhere on the board
/STM32/RCC_OSC_IN: C607.1, U602.12 (RCC_OSC_IN), Y601.1
/STM32/RCC_OSC_OUT: C609.1, U602.13 (RCC_OSC_OUT), Y601.3
/STM32/SPI1_CS: U602.29 (PA4); also elsewhere on the board
/STM32/SPI1_MISO: U602.31 (PA6); also elsewhere on the board
/STM32/SPI1_MOSI: U602.32 (PA7); also elsewhere on the board
/STM32/SPI1_SCK: U602.30 (PA5); also elsewhere on the board
/STM32/STM_3V3: C604.1, C606.1, C608.1, C610.1, C611.1, C612.1, C613.1, C614.1, FB601.2, J603.1, R601.1, R603.1, R605.1, R606.1, U601.2 (VO), U602.6 (VBAT), U602.11 (VDD), U602.28 (VDD), U602.50 (VDD), U602.75 (VDD), U602.100 (VDD)
/STM32/SYS_JTCK_SWCLK: J603.4, U602.76 (PA14)
/STM32/SYS_JTMS_SWDIO: J603.2, U602.72 (PA13)
/STM32/SYS_TRACESWO: J603.6, U602.89 (PB3)
/STM32/UART_RX: U602.79 (PC11); also elsewhere on the board
/STM32/UART_TX: U602.78 (PC10); also elsewhere on the board
/STM32/VDDA: C603.2, C605.2, C615.1, C616.1, FB601.1, U602.21 (VREF+), U602.22 (VDDA)
GNDD: C601.2, C602.2, C603.1, C604.2, C605.1, C606.2, C607.2, C608.2, C609.2, C610.2, C611.2, C612.2, C613.2, C614.2, C615.2, C616.2, D601.1 (K), J603.3, J603.5, J603.9, R602.2, R604.2, R607.1, R608.1, R609.1, R610.1, SW601.1, U601.1 (GND), U602.10 (VSS), U602.19 (VSSA), U602.20 (VREF-), U602.27 (VSS), U602.49 (VSS), U602.74 (VSS), U602.99 (VSS), Y601.2, Y601.4; also elsewhere on the board
unnamed: D601.2 (A), R605.2
unnamed: D602.1 (K), R607.2
unnamed: D602.2 (A), U602.80 (PC12)
unnamed: D603.1 (K), R608.2
unnamed: D603.2 (A), U602.7 (PC13)
unnamed: D604.1 (K), R609.2
unnamed: D604.2 (A), U602.8 (PC14)
unnamed: D605.1 (K), R610.2
unnamed: D605.2 (A), U602.9 (PC15)
unnamed: J601.1, R602.1
unnamed: J601.3, R601.2
unnamed: J602.1, R604.1
unnamed: J602.3, R603.2
unnamed: J606.1, U602.81 (PD0)
unnamed: J606.2, U602.82 (PD1)
unnamed: J606.3, U602.83 (PD2)
unnamed: J606.4, U602.84 (PD3)
unnamed: J606.5, U602.85 (PD4)
unnamed: J606.6, U602.86 (PD5)
unnamed: J606.7, U602.87 (PD6)
unnamed: J606.8, U602.88 (PD7)

Notes on the sheet:
Reset Pin
Boot Mode
VREF
Crystal OSC
Debug/Flash
Ethernet PHY Interface
SPI
STM32 Power
VDD Filtering
UART
ADC
VDDA filtering
I2C
