TheGreatChris/ethernet-sniffer/ethernet-sniffer/ethernet-sniffer.kicad_pcb

## KiCad design ethernet-sniffer/ethernet-sniffer.kicad_pcb (continued)

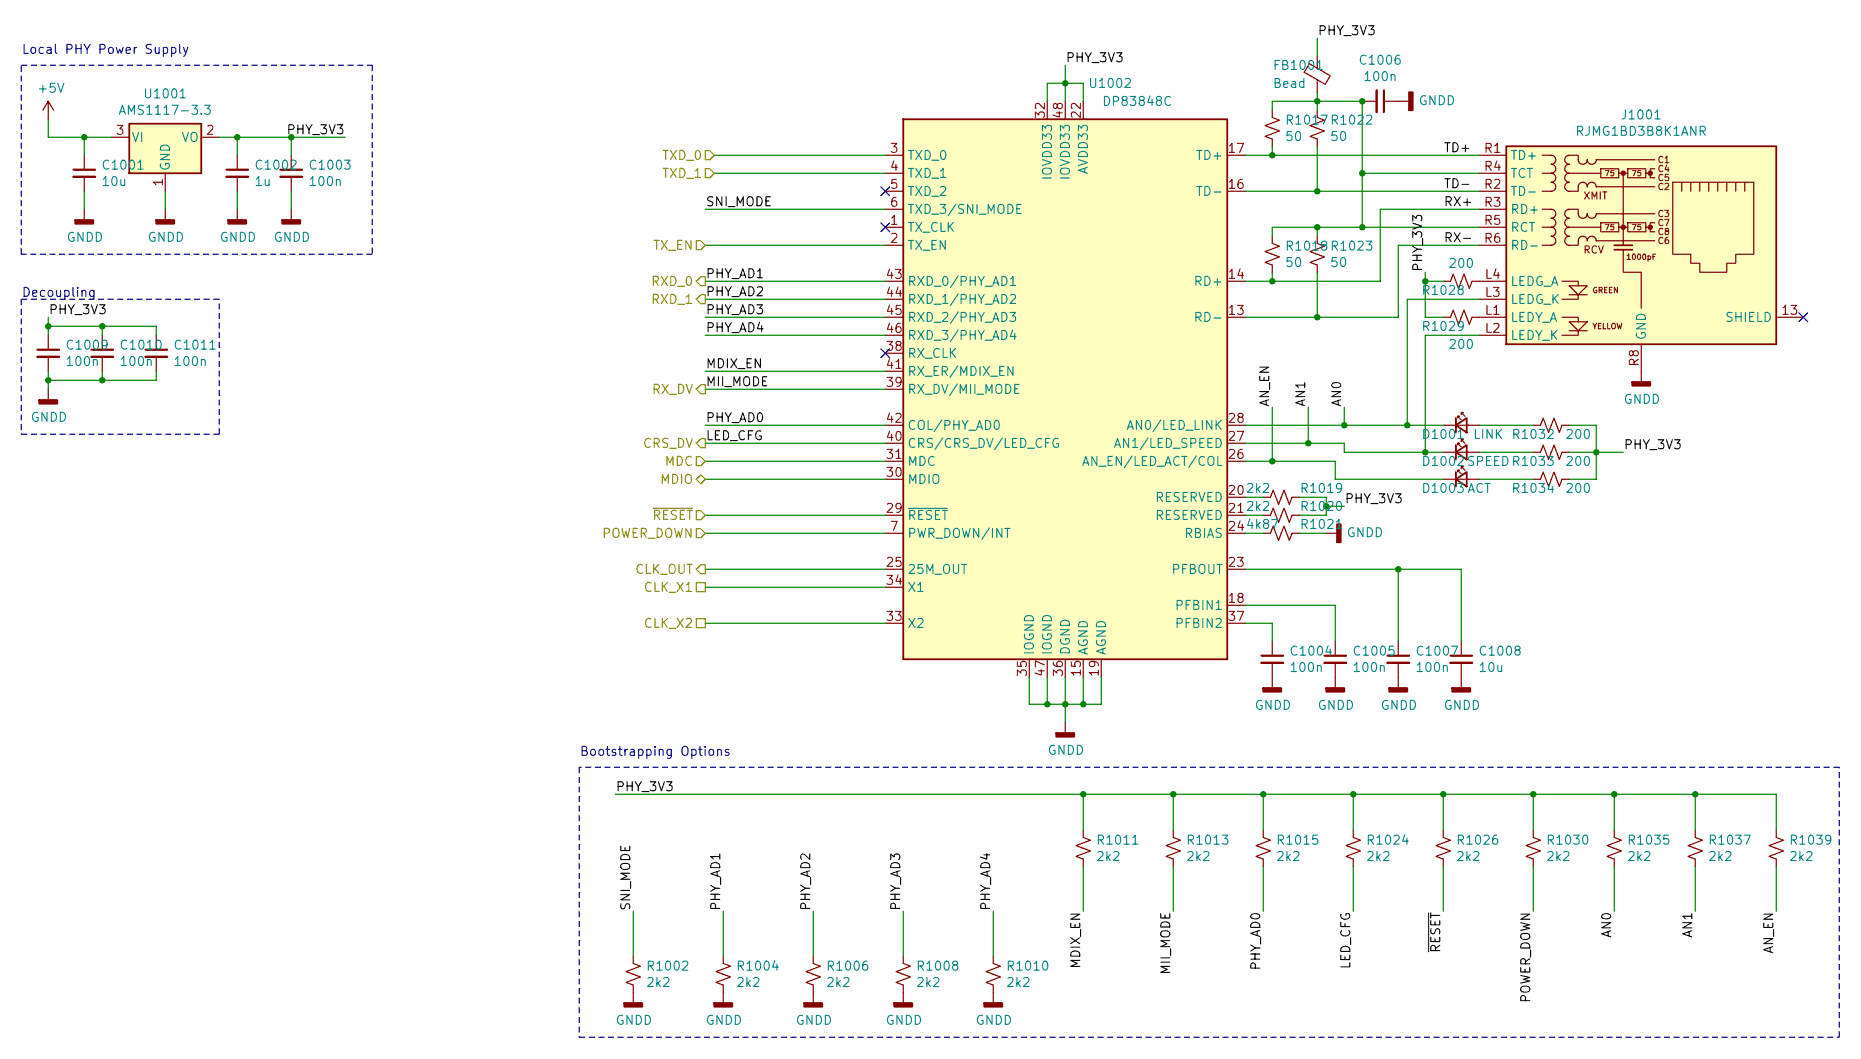
[picture p22: schematic PHY_fixed.sch]

Parts:
C801, C808: 10u; C_0402_1005Metric
C802: 1u; C_0402_1005Metric
C803, C804, C805, C806, C807, C1009, C1010, C1011: 100n; C_0402_1005Metric
D801: LINK; LED_0603_1608Metric
D802: SPEED; LED_0603_1608Metric
D803: ACT; LED_0603_1608Metric
FB801: Bead; L_0805_2012Metric
J801: RJMG1BD3B8K1ANR; RJ45_Amphenol_RJMG1BD3B8K1ANR
R802, R804, R806, R808, R810, R811, R813, R815, R819, R820, R824, R826, R830, R835, R837, R839: 2k2; R_0402_1005Metric
R817, R818, R822, R823: 50; R_0402_1005Metric
R821: 4k87; R_0402_1005Metric
R828, R829, R832, R833, R834: 200; R_0402_1005Metric
U801: AMS1117-3.3; SOT-223-3_TabPin2
U802: DP83848C; LQFP-48_7x7mm_P0.5mm

Connections:
+5V: C801.1, U801.3 (VI); also elsewhere on the board
/100BASETX-PHY 1/AN0: D801.1 (K), J801.L3 (LEDG_K), R835.2, U802.28 (AN0/LED_LINK)
/100BASETX-PHY 1/AN1: D802.1 (K), J801.L2 (LEDY_K), R837.2, U802.27 (AN1/LED_SPEED)
/100BASETX-PHY 1/AN_EN: D803.1 (K), R839.2, U802.26 (AN_EN/LED_ACT/COL)
/100BASETX-PHY 1/CLK_OUT: U802.25 (25M_OUT); also elsewhere on the board
/100BASETX-PHY 1/CLK_X2: U802.33 (X2)
/100BASETX-PHY 1/CRS_DV: R824.2, U802.40 (CRS/CRS_DV/LED_CFG); also elsewhere on the board
/100BASETX-PHY 1/MDC: U802.31 (MDC); also elsewhere on the board
/100BASETX-PHY 1/MDIO: U802.30 (MDIO); also elsewhere on the board
/100BASETX-PHY 1/MDIX_EN: R811.2, U802.41 (RX_ER/MDIX_EN)
/100BASETX-PHY 1/PHY_AD0: R815.2, U802.42 (COL/PHY_AD0)
/100BASETX-PHY 1/PHY_AD3: R808.1, U802.45 (RXD_2/PHY_AD3)
/100BASETX-PHY 1/PHY_AD4: R810.1, U802.46 (RXD_3/PHY_AD4)
/100BASETX-PHY 1/POWER_DOWN: R830.2, U802.7 (PWR_DOWN/INT)
/100BASETX-PHY 1/RX+: J801.R3 (RD+), R818.2, U802.14 (RD+)
/100BASETX-PHY 1/RX-: J801.R6 (RD-), R823.2, U802.13 (RD-)
/100BASETX-PHY 1/RX_DV: R813.2, U802.39 (RX_DV/MII_MODE)
/100BASETX-PHY 1/SNI_MODE: R802.1, U802.6 (TXD_3/SNI_MODE)
/100BASETX-PHY 1/TD+: J801.R1 (TD+), R817.2, U802.17 (TD+)
/100BASETX-PHY 1/TD-: J801.R2 (TD-), R822.2, U802.16 (TD-)
/100BASETX-PHY 1/~RESET: R826.2, U802.29 (~RESET~)
/FPGA/CLK_IN: U802.34 (X1); also elsewhere on the board
/STM32/PHY_RXD_0: R804.1, U802.43 (RXD_0/PHY_AD1); also elsewhere on the board
/STM32/PHY_RXD_1: R806.1, U802.44 (RXD_1/PHY_AD2); also elsewhere on the board
/STM32/PHY_TXD_0: U802.3 (TXD_0); also elsewhere on the board
/STM32/PHY_TXD_1: U802.4 (TXD_1); also elsewhere on the board
/STM32/PHY_TX_EN: U802.2 (TX_EN); also elsewhere on the board
GNDD: C801.2, C802.2, C803.2, C804.2, C805.2, C806.1, C807.2, C808.2, C1009.2, C1010.2, C1011.2, J801.R8 (GND), R802.2, R804.2, R806.2, R808.2, R810.2, R821.1, U801.1 (GND), U802.15 (AGND), U802.19 (AGND), U802.35 (IOGND), U802.36 (DGND), U802.47 (IOGND); also elsewhere on the board
unnamed: C804.1, U802.37 (PFBIN2)
unnamed: C805.1, U802.18 (PFBIN1)
unnamed: C806.2, FB801.2, J801.R4 (TCT), J801.R5 (RCT), R817.1, R818.1, R822.1, R823.1
unnamed: C807.1, C808.1, U802.23 (PFBOUT)
unnamed: D801.2 (A), R832.2
unnamed: D802.2 (A), R833.2
unnamed: D803.2 (A), R834.2
unnamed: J801.L1 (LEDY_A), R829.1
unnamed: J801.L4 (LEDG_A), R828.1
unnamed: R819.2, U802.20 (RESERVED)
unnamed: R820.2, U802.21 (RESERVED)
unnamed: R821.2, U802.24 (RBIAS)

Parts of its further copies:
C809, C810, C811, C903, C904, C905, C906, C907, C909, C910, C911, C1003, C1004, C1005, C1006, C1007, C1103, C1104, C1105, C1106, C1107, C1109, C1110, C1111: 100n; C_0402_1005Metric
C901, C908, C1001, C1008, C1101, C1108: 10u; C_0402_1005Metric
C902, C1002, C1102: 1u; C_0402_1005Metric
D901, D1001, D1101: LINK; LED_0603_1608Metric
D902, D1002, D1102: SPEED; LED_0603_1608Metric
D903, D1003, D1103: ACT; LED_0603_1608Metric
FB901, FB1001, FB1101: Bead; L_0805_2012Metric
J901, J1001, J1101: RJMG1BD3B8K1ANR; RJ45_Amphenol_RJMG1BD3B8K1ANR
R902, R904, R906, R908, R910, R911, R913, R915, R919, R920, R924, R926, R930, R935, R937, R939, R1002, R1004, R1006, R1008, R1010, R1011, R1013, R1015, R1019, R1020, R1024, R1026, R1030, R1035, R1037, R1039, R1102, R1104, R1106, R1108, R1110, R1111, R1113, R1115, R1119, R1120, R1124, R1126, R1130, R1135, R1137, R1139: 2k2; R_0402_1005Metric
R917, R918, R922, R923, R1017, R1018, R1022, R1023, R1117, R1118, R1122, R1123: 50; R_0402_1005Metric
R921, R1021, R1121: 4k87; R_0402_1005Metric
R928, R929, R932, R933, R934, R1028, R1029, R1032, R1033, R1034, R1128, R1129, R1132, R1133, R1134: 200; R_0402_1005Metric
U901, U1001, U1101: AMS1117-3.3; SOT-223-3_TabPin2
U902, U1002, U1102: DP83848C; LQFP-48_7x7mm_P0.5mm

Connections of its further copies:
+5V: C901.1, C1001.1, C1101.1, U901.3 (VI), U1001.3 (VI), U1101.3 (VI); also elsewhere on the board
/FPGA/PHY1_POWER_DOWN: R930.2, U902.7 (PWR_DOWN/INT); also elsewhere on the board
/FPGA/PHY1_RXD_0: R904.1, U902.43 (RXD_0/PHY_AD1); also elsewhere on the board
/FPGA/PHY1_RXD_1: R906.1, U902.44 (RXD_1/PHY_AD2); also elsewhere on the board
/FPGA/PHY1_RX_DV: R913.2, U902.39 (RX_DV/MII_MODE); also elsewhere on the board
/FPGA/PHY1_TXD_0: U902.3 (TXD_0); also elsewhere on the board
/FPGA/PHY1_TXD_1: U902.4 (TXD_1); also elsewhere on the board
/FPGA/PHY1_TX_EN: U902.2 (TX_EN); also elsewhere on the board
/FPGA/PHY2_POWER_DOWN: R1030.2, U1002.7 (PWR_DOWN/INT); also elsewhere on the board
/FPGA/PHY2_RXD_0: R1004.1, U1002.43 (RXD_0/PHY_AD1); also elsewhere on the board
/FPGA/PHY2_RXD_1: R1006.1, U1002.44 (RXD_1/PHY_AD2); also elsewhere on the board
/FPGA/PHY2_RX_DV: R1013.2, U1002.39 (RX_DV/MII_MODE); also elsewhere on the board
/FPGA/PHY2_TXD_0: U1002.3 (TXD_0); also elsewhere on the board
/FPGA/PHY2_TXD_1: U1002.4 (TXD_1); also elsewhere on the board
/FPGA/PHY2_TX_EN: U1002.2 (TX_EN); also elsewhere on the board
/FPGA/PHY3_POWER_DOWN: R1130.2, U1102.7 (PWR_DOWN/INT); also elsewhere on the board
/FPGA/PHY3_RXD_0: R1104.1, U1102.43 (RXD_0/PHY_AD1); also elsewhere on the board
/FPGA/PHY3_RXD_1: R1106.1, U1102.44 (RXD_1/PHY_AD2); also elsewhere on the board
/FPGA/PHY3_RX_DV: R1113.2, U1102.39 (RX_DV/MII_MODE); also elsewhere on the board
/FPGA/PHY3_TXD_0: U1102.3 (TXD_0); also elsewhere on the board
/FPGA/PHY3_TXD_1: U1102.4 (TXD_1); also elsewhere on the board
/FPGA/PHY3_TX_EN: U1102.2 (TX_EN); also elsewhere on the board
/FPGA/~PHY1_RESET: R926.2, U902.29 (~RESET~); also elsewhere on the board
/FPGA/~PHY2_RESET: R1026.2, U1002.29 (~RESET~); also elsewhere on the board
/FPGA/~PHY3_RESET: R1126.2, U1102.29 (~RESET~); also elsewhere on the board
/PHY1/AN0: D901.1 (K), J901.L3 (LEDG_K), R935.2, U902.28 (AN0/LED_LINK)
/PHY1/AN1: D902.1 (K), J901.L2 (LEDY_K), R937.2, U902.27 (AN1/LED_SPEED)
/PHY1/AN_EN: D903.1 (K), R939.2, U902.26 (AN_EN/LED_ACT/COL)
/PHY1/CLK_OUT: U902.25 (25M_OUT); also elsewhere on the board
/PHY1/CLK_X1: U902.34 (X1); also elsewhere on the board
/PHY1/CLK_X2: U902.33 (X2)
/PHY1/CRS_DV: R924.2, U902.40 (CRS/CRS_DV/LED_CFG); also elsewhere on the board
/PHY1/MDC: U902.31 (MDC); also elsewhere on the board
/PHY1/MDIO: U902.30 (MDIO); also elsewhere on the board
/PHY1/MDIX_EN: R911.2, U902.41 (RX_ER/MDIX_EN)
/PHY1/PHY_3V3: C902.1, C903.1, C909.1, C910.1, C911.1, FB901.1, R911.1, R913.1, R915.1, R919.1, R920.1, R924.1, R926.1, R928.2, R929.2, R930.1, R932.1, R933.1, R934.1, R935.1, R937.1, R939.1, U901.2 (VO), U902.22 (AVDD33), U902.32 (IOVDD33), U902.48 (IOVDD33)
/PHY1/PHY_AD0: R915.2, U902.42 (COL/PHY_AD0)
/PHY1/PHY_AD3: R908.1, U902.45 (RXD_2/PHY_AD3)
/PHY1/PHY_AD4: R910.1, U902.46 (RXD_3/PHY_AD4)
/PHY1/RX+: J901.R3 (RD+), R918.2, U902.14 (RD+)
/PHY1/RX-: J901.R6 (RD-), R923.2, U902.13 (RD-)
/PHY1/SNI_MODE: R902.1, U902.6 (TXD_3/SNI_MODE)
/PHY1/TD+: J901.R1 (TD+), R917.2, U902.17 (TD+)
/PHY1/TD-: J901.R2 (TD-), R922.2, U902.16 (TD-)
/PHY2/AN0: D1001.1 (K), J1001.L3 (LEDG_K), R1035.2, U1002.28 (AN0/LED_LINK)
/PHY2/AN1: D1002.1 (K), J1001.L2 (LEDY_K), R1037.2, U1002.27 (AN1/LED_SPEED)
/PHY2/AN_EN: D1003.1 (K), R1039.2, U1002.26 (AN_EN/LED_ACT/COL)
/PHY2/CLK_OUT: U1002.25 (25M_OUT); also elsewhere on the board
/PHY2/CLK_X1: U1002.34 (X1); also elsewhere on the board
/PHY2/CLK_X2: U1002.33 (X2)
/PHY2/CRS_DV: R1024.2, U1002.40 (CRS/CRS_DV/LED_CFG); also elsewhere on the board
/PHY2/MDC: U1002.31 (MDC); also elsewhere on the board
/PHY2/MDIO: U1002.30 (MDIO); also elsewhere on the board
/PHY2/MDIX_EN: R1011.2, U1002.41 (RX_ER/MDIX_EN)
/PHY2/PHY_AD0: R1015.2, U1002.42 (COL/PHY_AD0)
/PHY2/PHY_AD3: R1008.1, U1002.45 (RXD_2/PHY_AD3)
/PHY2/PHY_AD4: R1010.1, U1002.46 (RXD_3/PHY_AD4)
/PHY2/RX+: J1001.R3 (RD+), R1018.2, U1002.14 (RD+)
/PHY2/RX-: J1001.R6 (RD-), R1023.2, U1002.13 (RD-)
/PHY2/SNI_MODE: R1002.1, U1002.6 (TXD_3/SNI_MODE)
/PHY2/TD+: J1001.R1 (TD+), R1017.2, U1002.17 (TD+)
/PHY2/TD-: J1001.R2 (TD-), R1022.2, U1002.16 (TD-)
/PHY3/AN0: D1101.1 (K), J1101.L3 (LEDG_K), R1135.2, U1102.28 (AN0/LED_LINK)
/PHY3/AN1: D1102.1 (K), J1101.L2 (LEDY_K), R1137.2, U1102.27 (AN1/LED_SPEED)
/PHY3/AN_EN: D1103.1 (K), R1139.2, U1102.26 (AN_EN/LED_ACT/COL)
/PHY3/CLK_OUT: U1102.25 (25M_OUT); also elsewhere on the board
/PHY3/CLK_X1: U1102.34 (X1); also elsewhere on the board
/PHY3/CLK_X2: U1102.33 (X2)
/PHY3/CRS_DV: R1124.2, U1102.40 (CRS/CRS_DV/LED_CFG); also elsewhere on the board
/PHY3/MDC: U1102.31 (MDC); also elsewhere on the board
/PHY3/MDIO: U1102.30 (MDIO); also elsewhere on the board
/PHY3/MDIX_EN: R1111.2, U1102.41 (RX_ER/MDIX_EN)
/PHY3/PHY_3V3: C1102.1, C1103.1, C1109.1, C1110.1, C1111.1, FB1101.1, R1111.1, R1113.1, R1115.1, R1119.1, R1120.1, R1124.1, R1126.1, R1128.2, R1129.2, R1130.1, R1132.1, R1133.1, R1134.1, R1135.1, R1137.1, R1139.1, U1101.2 (VO), U1102.22 (AVDD33), U1102.32 (IOVDD33), U1102.48 (IOVDD33)
/PHY3/PHY_AD0: R1115.2, U1102.42 (COL/PHY_AD0)
/PHY3/PHY_AD3: R1108.1, U1102.45 (RXD_2/PHY_AD3)
/PHY3/PHY_AD4: R1110.1, U1102.46 (RXD_3/PHY_AD4)
/PHY3/RX+: J1101.R3 (RD+), R1118.2, U1102.14 (RD+)
/PHY3/RX-: J1101.R6 (RD-), R1123.2, U1102.13 (RD-)
/PHY3/SNI_MODE: R1102.1, U1102.6 (TXD_3/SNI_MODE)
/PHY3/TD+: J1101.R1 (TD+), R1117.2, U1102.17 (TD+)
/PHY3/TD-: J1101.R2 (TD-), R1122.2, U1102.16 (TD-)
GNDD: C809.2, C810.2, C811.2, C901.2, C902.2, C903.2, C904.2, C905.2, C906.1, C907.2, C908.2, C909.2, C910.2, C911.2, C1001.2, C1002.2, C1003.2, C1004.2, C1005.2, C1006.1, C1007.2, C1008.2, C1101.2, C1102.2, C1103.2, C1104.2, C1105.2, C1106.1, C1107.2, C1108.2, C1109.2, C1110.2, C1111.2, J901.R8 (GND), J1001.R8 (GND), J1101.R8 (GND), R902.2, R904.2, R906.2, R908.2, R910.2, R921.1, R1002.2, R1004.2, R1006.2, R1008.2, R1010.2, R1021.1, R1102.2, R1104.2, R1106.2, R1108.2, R1110.2, R1121.1, U901.1 (GND), U902.15 (AGND), U902.19 (AGND), U902.35 (IOGND), U902.36 (DGND), U902.47 (IOGND), U1001.1 (GND), U1002.15 (AGND), U1002.19 (AGND), U1002.35 (IOGND), U1002.36 (DGND), U1002.47 (IOGND), U1101.1 (GND), U1102.15 (AGND), U1102.19 (AGND), U1102.35 (IOGND), U1102.36 (DGND), U1102.47 (IOGND); also elsewhere on the board
unnamed: C904.1, U902.37 (PFBIN2)
unnamed: C905.1, U902.18 (PFBIN1)
unnamed: C906.2, FB901.2, J901.R4 (TCT), J901.R5 (RCT), R917.1, R918.1, R922.1, R923.1
unnamed: C907.1, C908.1, U902.23 (PFBOUT)
unnamed: C1004.1, U1002.37 (PFBIN2)
unnamed: C1005.1, U1002.18 (PFBIN1)
unnamed: C1006.2, FB1001.2, J1001.R4 (TCT), J1001.R5 (RCT), R1017.1, R1018.1, R1022.1, R1023.1
unnamed: C1007.1, C1008.1, U1002.23 (PFBOUT)
unnamed: C1104.1, U1102.37 (PFBIN2)
unnamed: C1105.1, U1102.18 (PFBIN1)
unnamed: C1106.2, FB1101.2, J1101.R4 (TCT), J1101.R5 (RCT), R1117.1, R1118.1, R1122.1, R1123.1
unnamed: C1107.1, C1108.1, U1102.23 (PFBOUT)
unnamed: D901.2 (A), R932.2
unnamed: D902.2 (A), R933.2
unnamed: D903.2 (A), R934.2
unnamed: D1001.2 (A), R1032.2
unnamed: D1002.2 (A), R1033.2
unnamed: D1003.2 (A), R1034.2
unnamed: D1101.2 (A), R1132.2
unnamed: D1102.2 (A), R1133.2
unnamed: D1103.2 (A), R1134.2
unnamed: J901.L1 (LEDY_A), R929.1
unnamed: J901.L4 (LEDG_A), R928.1
unnamed: J1001.L1 (LEDY_A), R1029.1
unnamed: J1001.L4 (LEDG_A), R1028.1
unnamed: J1101.L1 (LEDY_A), R1129.1
unnamed: J1101.L4 (LEDG_A), R1128.1
unnamed: R919.2, U902.20 (RESERVED)
unnamed: R920.2, U902.21 (RESERVED)
unnamed: R921.2, U902.24 (RBIAS)
unnamed: R1019.2, U1002.20 (RESERVED)
unnamed: R1020.2, U1002.21 (RESERVED)
unnamed: R1021.2, U1002.24 (RBIAS)
unnamed: R1119.2, U1102.20 (RESERVED)
unnamed: R1120.2, U1102.21 (RESERVED)
unnamed: R1121.2, U1102.24 (RBIAS)

Notes on the sheet:
Bootstrapping Options
Local PHY Power Supply
Decoupling

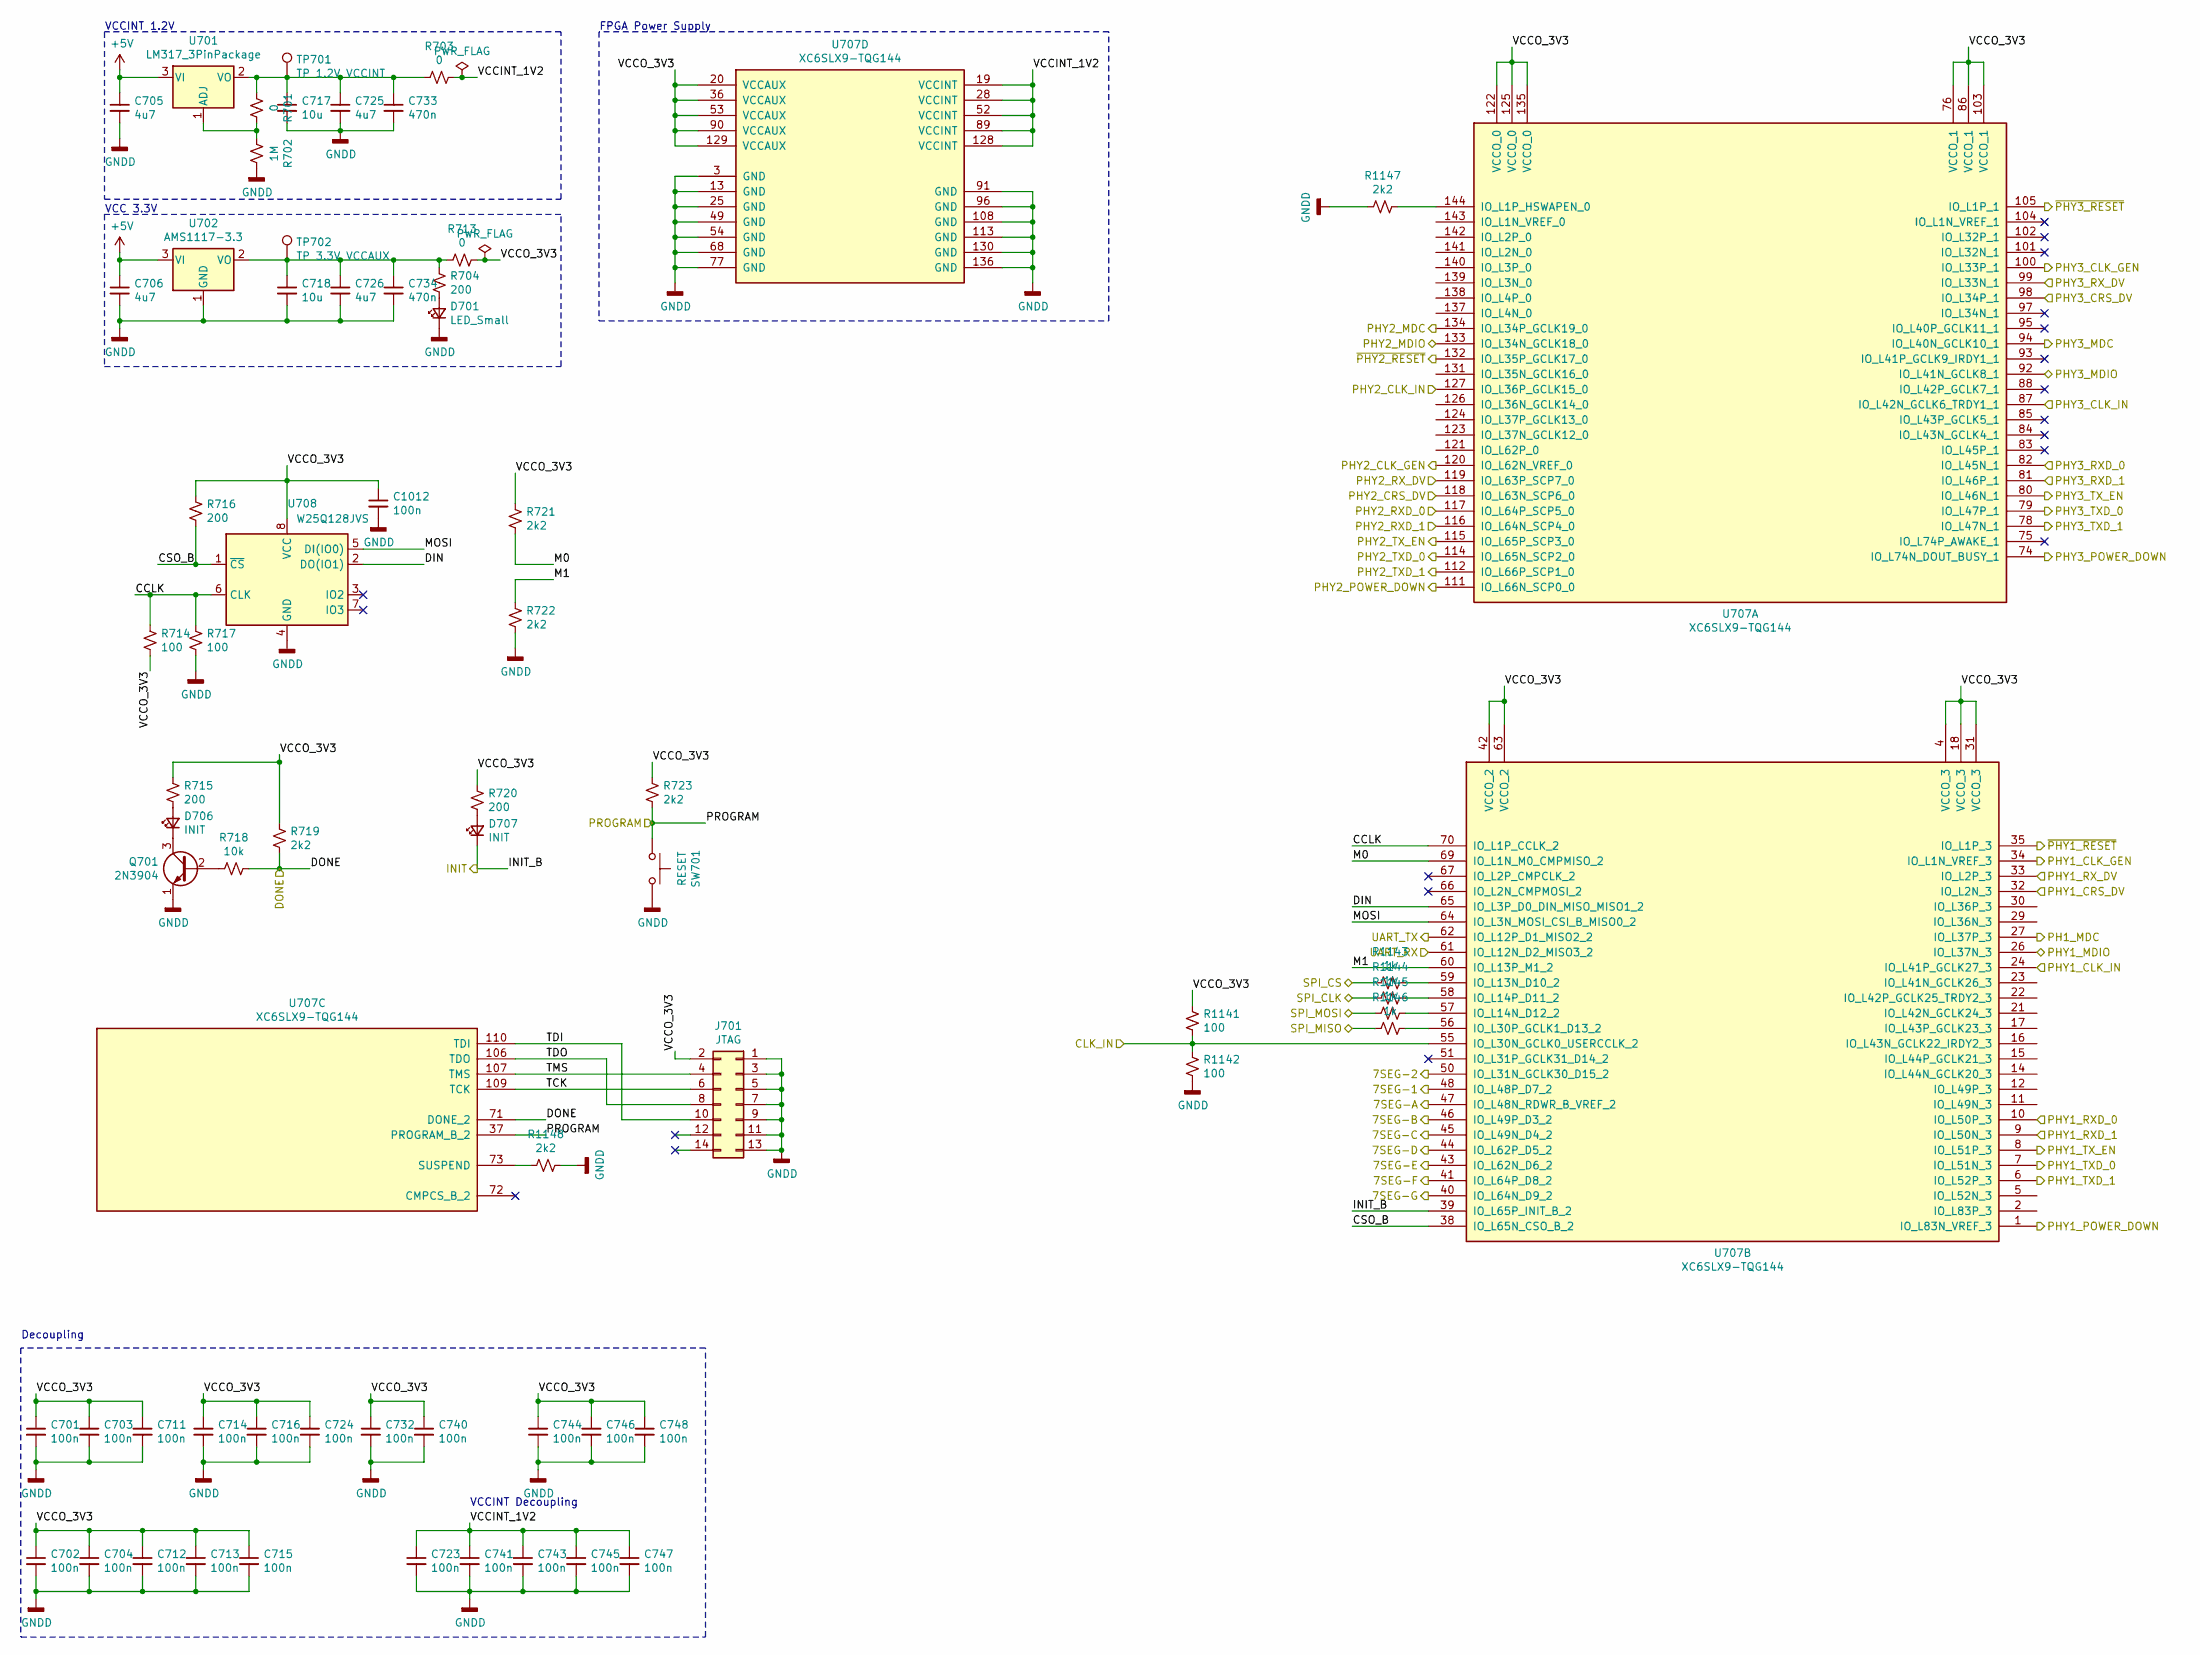
[picture p23: schematic FPGA.sch]

Parts:
C701, C702, C703, C704, C711, C712, C713, C714, C715, C716, C723, C724, C732, C740, C741, C743, C744, C745, C746, C747, C748, C1012: 100n; C_0402_1005Metric
C705, C706, C725, C726: 4u7; C_0402_1005Metric
C717, C718: 10u; C_0402_1005Metric
C733, C734: 470n; C_0402_1005Metric
D701: LED_Small; LED_0603_1608Metric
D706, D707: INIT; LED_0603_1608Metric
J701: JTAG; PinHeader_2x07_P2.54mm_Vertical
Q701: 2N3904; SOT-23
R701, R703, R713: 0; R_0402_1005Metric
R702: 1M; R_0402_1005Metric
R704, R715, R716, R720: 200; R_0402_1005Metric
R714, R717, R1141, R1142: 100; R_0402_1005Metric
R718: 10k; R_0402_1005Metric
R719, R721, R722, R723, R1147, R1148: 2k2; R_0402_1005Metric
R1143, R1144, R1145, R1146: 1k; R_0402_1005Metric
SW701: RESET; SW_Push_SPST_NO_Alps_SKRK
TP701: TP 1.2V VCCINT; TestPoint_Keystone_5015_Micro-Minature
TP702: TP 3.3V VCCAUX; TestPoint_Keystone_5015_Micro-Minature
U701: LM317_3PinPackage; TO-252-2
U702: AMS1117-3.3; SOT-223-3_TabPin2
U707: XC6SLX9-TQG144; LQFP-144_20x20mm_P0.5mm
U708: W25Q128JVS; SOIC-8_5.23x5.23mm_P1.27mm

Connections:
+5V: C705.1, C706.1, U701.3 (VI), U702.3 (VI); also elsewhere on the board
/7seg-display/7SEG-1: U707.48 (IO_L48P_D7_2); also elsewhere on the board
/7seg-display/7SEG-2: U707.50 (IO_L31N_GCLK30_D15_2); also elsewhere on the board
/7seg-display/7SEG-A: U707.47 (IO_L48N_RDWR_B_VREF_2); also elsewhere on the board
/7seg-display/7SEG-B: U707.46 (IO_L49P_D3_2); also elsewhere on the board
/7seg-display/7SEG-C: U707.45 (IO_L49N_D4_2); also elsewhere on the board
/7seg-display/7SEG-D: U707.44 (IO_L62P_D5_2); also elsewhere on the board
/7seg-display/7SEG-E: U707.43 (IO_L62N_D6_2); also elsewhere on the board
/7seg-display/7SEG-F: U707.41 (IO_L64P_D8_2); also elsewhere on the board
/7seg-display/7SEG-G: U707.40 (IO_L64N_D9_2); also elsewhere on the board
/FPGA/CCLK: R714.1, R717.1, U707.70 (IO_L1P_CCLK_2), U708.6 (CLK)
/FPGA/CLK_IN: R1141.2, R1142.1, U707.55 (IO_L30N_GCLK0_USERCCLK_2); also elsewhere on the board
/FPGA/CSO_B: R716.2, U707.38 (IO_L65N_CSO_B_2), U708.1 (~CS)
/FPGA/DIN: U707.65 (IO_L3P_D0_DIN_MISO_MISO1_2), U708.2 (DO(IO1))
/FPGA/DONE: R718.1, R719.2, U707.71 (DONE_2); also elsewhere on the board
/FPGA/M0: R721.2, U707.69 (IO_L1N_M0_CMPMISO_2)
/FPGA/M1: R722.1, U707.60 (IO_L13P_M1_2)
/FPGA/MOSI: U707.64 (IO_L3N_MOSI_CSI_B_MISO0_2), U708.5 (DI(IO0))
/FPGA/PHY1_POWER_DOWN: U707.1 (IO_L83N_VREF_3); also elsewhere on the board
/FPGA/PHY1_RXD_0: U707.10 (IO_L50P_3); also elsewhere on the board
/FPGA/PHY1_RXD_1: U707.9 (IO_L50N_3); also elsewhere on the board
/FPGA/PHY1_RX_DV: U707.33 (IO_L2P_3); also elsewhere on the board
/FPGA/PHY1_TXD_0: U707.7 (IO_L51N_3); also elsewhere on the board
/FPGA/PHY1_TXD_1: U707.6 (IO_L52P_3); also elsewhere on the board
/FPGA/PHY1_TX_EN: U707.8 (IO_L51P_3); also elsewhere on the board
/FPGA/PHY2_POWER_DOWN: U707.111 (IO_L66N_SCP0_0); also elsewhere on the board
/FPGA/PHY2_RXD_0: U707.117 (IO_L64P_SCP5_0); also elsewhere on the board
/FPGA/PHY2_RXD_1: U707.116 (IO_L64N_SCP4_0); also elsewhere on the board
/FPGA/PHY2_RX_DV: U707.119 (IO_L63P_SCP7_0); also elsewhere on the board
/FPGA/PHY2_TXD_0: U707.114 (IO_L65N_SCP2_0); also elsewhere on the board
/FPGA/PHY2_TXD_1: U707.112 (IO_L66P_SCP1_0); also elsewhere on the board
/FPGA/PHY2_TX_EN: U707.115 (IO_L65P_SCP3_0); also elsewhere on the board
/FPGA/PHY3_POWER_DOWN: U707.74 (IO_L74N_DOUT_BUSY_1); also elsewhere on the board
/FPGA/PHY3_RXD_0: U707.82 (IO_L45N_1); also elsewhere on the board
/FPGA/PHY3_RXD_1: U707.81 (IO_L46P_1); also elsewhere on the board
/FPGA/PHY3_RX_DV: U707.99 (IO_L33N_1); also elsewhere on the board
/FPGA/PHY3_TXD_0: U707.79 (IO_L47P_1); also elsewhere on the board
/FPGA/PHY3_TXD_1: U707.78 (IO_L47N_1); also elsewhere on the board
/FPGA/PHY3_TX_EN: U707.80 (IO_L46N_1); also elsewhere on the board
/FPGA/TCK: J701.6, U707.109 (TCK)
/FPGA/TDI: J701.10, U707.110 (TDI)
/FPGA/TDO: J701.8, U707.106 (TDO)
/FPGA/TMS: J701.4, U707.107 (TMS)
/FPGA/VCCINT_1V2: C723.1, C741.1, C743.1, C745.1, C747.1, R703.1, U707.19 (VCCINT), U707.28 (VCCINT), U707.52 (VCCINT), U707.89 (VCCINT), U707.128 (VCCINT)
/FPGA/VCCO_3V3: C701.1, C702.1, C703.1, C704.1, C711.1, C712.1, C713.1, C714.1, C715.1, C716.1, C724.1, C732.1, C740.1, C744.1, C746.1, C748.1, C1012.1, J701.2, R713.1, R714.2, R715.1, R716.1, R719.1, R720.1, R721.1, R723.1, R1141.1, U707.4 (VCCO_3), U707.18 (VCCO_3), U707.20 (VCCAUX), U707.31 (VCCO_3), U707.36 (VCCAUX), U707.42 (VCCO_2), U707.53 (VCCAUX), U707.63 (VCCO_2), U707.76 (VCCO_1), U707.86 (VCCO_1), U707.90 (VCCAUX), U707.103 (VCCO_1), U707.122 (VCCO_0), U707.125 (VCCO_0), U707.129 (VCCAUX), U707.135 (VCCO_0), U708.8 (VCC)
/FPGA/~PHY1_RESET: U707.35 (IO_L1P_3); also elsewhere on the board
/FPGA/~PHY2_RESET: U707.132 (IO_L35P_GCLK17_0); also elsewhere on the board
/FPGA/~PHY3_RESET: U707.105 (IO_L1P_1); also elsewhere on the board
/PHY1/CLK_OUT: U707.24 (IO_L41P_GCLK27_3); also elsewhere on the board
/PHY1/CLK_X1: U707.34 (IO_L1N_VREF_3); also elsewhere on the board
/PHY1/CRS_DV: U707.32 (IO_L2N_3); also elsewhere on the board
/PHY1/MDC: U707.27 (IO_L37P_3); also elsewhere on the board
/PHY1/MDIO: U707.26 (IO_L37N_3); also elsewhere on the board
/PHY2/CLK_OUT: U707.127 (IO_L36P_GCLK15_0); also elsewhere on the board
/PHY2/CLK_X1: U707.120 (IO_L62N_VREF_0); also elsewhere on the board
/PHY2/CRS_DV: U707.118 (IO_L63N_SCP6_0); also elsewhere on the board
/PHY2/MDC: U707.134 (IO_L34P_GCLK19_0); also elsewhere on the board
/PHY2/MDIO: U707.133 (IO_L34N_GCLK18_0); also elsewhere on the board
/PHY3/CLK_OUT: U707.87 (IO_L42N_GCLK6_TRDY1_1); also elsewhere on the board
/PHY3/CLK_X1: U707.100 (IO_L33P_1); also elsewhere on the board
/PHY3/CRS_DV: U707.98 (IO_L34P_1); also elsewhere on the board
/PHY3/MDC: U707.94 (IO_L40N_GCLK10_1); also elsewhere on the board
/PHY3/MDIO: U707.92 (IO_L41N_GCLK8_1); also elsewhere on the board
/STM32/FPGA_INIT: D707.1 (K), U707.39 (IO_L65P_INIT_B_2); also elsewhere on the board
/STM32/FPGA_PROGRAM: R723.2, SW701.1, U707.37 (PROGRAM_B_2); also elsewhere on the board
/STM32/SPI1_CS: R1143.2; also elsewhere on the board
/STM32/SPI1_MISO: R1145.2; also elsewhere on the board
/STM32/SPI1_MOSI: R1146.2; also elsewhere on the board
/STM32/SPI1_SCK: R1144.2; also elsewhere on the board
/USB-UART/UART-RX: U707.62 (IO_L12P_D1_MISO2_2); also elsewhere on the board
/USB-UART/UART-TX: U707.61 (IO_L12N_D2_MISO3_2); also elsewhere on the board
GNDD: C701.2, C702.2, C703.2, C704.2, C705.2, C706.2, C711.2, C712.2, C713.2, C714.2, C715.2, C716.2, C717.2, C718.2, C723.2, C724.2, C725.2, C726.2, C732.2, C733.2, C734.2, C740.2, C741.2, C743.2, C744.2, C745.2, C746.2, C747.2, C748.2, C1012.2, D701.1 (K), J701.1, J701.3, J701.5, J701.7, J701.9, J701.11, J701.13, Q701.1 (E), R702.1, R717.2, R722.2, R1142.2, R1147.2, R1148.1, SW701.2, U702.1 (GND), U707.3 (GND), U707.13 (GND), U707.25 (GND), U707.49 (GND), U707.54 (GND), U707.68 (GND), U707.77 (GND), U707.91 (GND), U707.96 (GND), U707.108 (GND), U707.113 (GND), U707.130 (GND), U707.136 (GND), U708.4 (GND); also elsewhere on the board
unnamed: C717.1, C725.1, C733.1, R701.2, R703.2, TP701.1, U701.2 (VO)
unnamed: C718.1, C726.1, C734.1, R704.1, R713.2, TP702.1, U702.2 (VO)
unnamed: D701.2 (A), R704.2
unnamed: D706.1 (K), Q701.3 (C)
unnamed: D706.2 (A), R715.2
unnamed: D707.2 (A), R720.2
unnamed: Q701.2 (B), R718.2
unnamed: R701.1, R702.2, U701.1 (ADJ)
unnamed: R1143.1, U707.59 (IO_L13N_D10_2)
unnamed: R1144.1, U707.58 (IO_L14P_D11_2)
unnamed: R1145.1, U707.57 (IO_L14N_D12_2)
unnamed: R1146.1, U707.56 (IO_L30P_GCLK1_D13_2)
unnamed: R1147.1, U707.144 (IO_L1P_HSWAPEN_0)
unnamed: R1148.2, U707.73 (SUSPEND)

Notes on the sheet:
Decoupling
VCCINT 1.2V
VCC 3.3V
VCCINT Decoupling
FPGA Power Supply


Parts:
D301: B; LED_0603_1608Metric
D302: C; LED_0603_1608Metric
D303: A; LED_0603_1608Metric
D304: G; LED_0603_1608Metric
D305: D; LED_0603_1608Metric
D306: F; LED_0603_1608Metric
D307: E; LED_0603_1608Metric

Connections:
/7seg-display/Digit 1/AK: D301.1 (K), D302.1 (K), D303.1 (K), D304.1 (K), D305.1 (K), D306.1 (K), D307.1 (K); also elsewhere on the board
/7seg-display/Digit 1/AN: D303.2 (A); also elsewhere on the board
/7seg-display/Digit 1/BA: D301.2 (A); also elsewhere on the board
/7seg-display/Digit 1/CA: D302.2 (A); also elsewhere on the board
/7seg-display/Digit 1/DA: D305.2 (A); also elsewhere on the board
/7seg-display/Digit 1/EA: D307.2 (A); also elsewhere on the board
/7seg-display/Digit 1/FA: D306.2 (A); also elsewhere on the board
/7seg-display/Digit 1/GA: D304.2 (A); also elsewhere on the board

Parts of its further copies:
D401: B; LED_0603_1608Metric
D402: C; LED_0603_1608Metric
D403: A; LED_0603_1608Metric
D404: G; LED_0603_1608Metric
D405: D; LED_0603_1608Metric
D406: F; LED_0603_1608Metric
D407: E; LED_0603_1608Metric

Connections of its further copies:
/7seg-display/Digit 1/AN: D403.2 (A); also elsewhere on the board
/7seg-display/Digit 1/BA: D401.2 (A); also elsewhere on the board
/7seg-display/Digit 1/CA: D402.2 (A); also elsewhere on the board
/7seg-display/Digit 1/DA: D405.2 (A); also elsewhere on the board
/7seg-display/Digit 1/EA: D407.2 (A); also elsewhere on the board
/7seg-display/Digit 1/FA: D406.2 (A); also elsewhere on the board
/7seg-display/Digit 1/GA: D404.2 (A); also elsewhere on the board
/7seg-display/Digit 2/AK: D401.1 (K), D402.1 (K), D403.1 (K), D404.1 (K), D405.1 (K), D406.1 (K), D407.1 (K); also elsewhere on the board

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
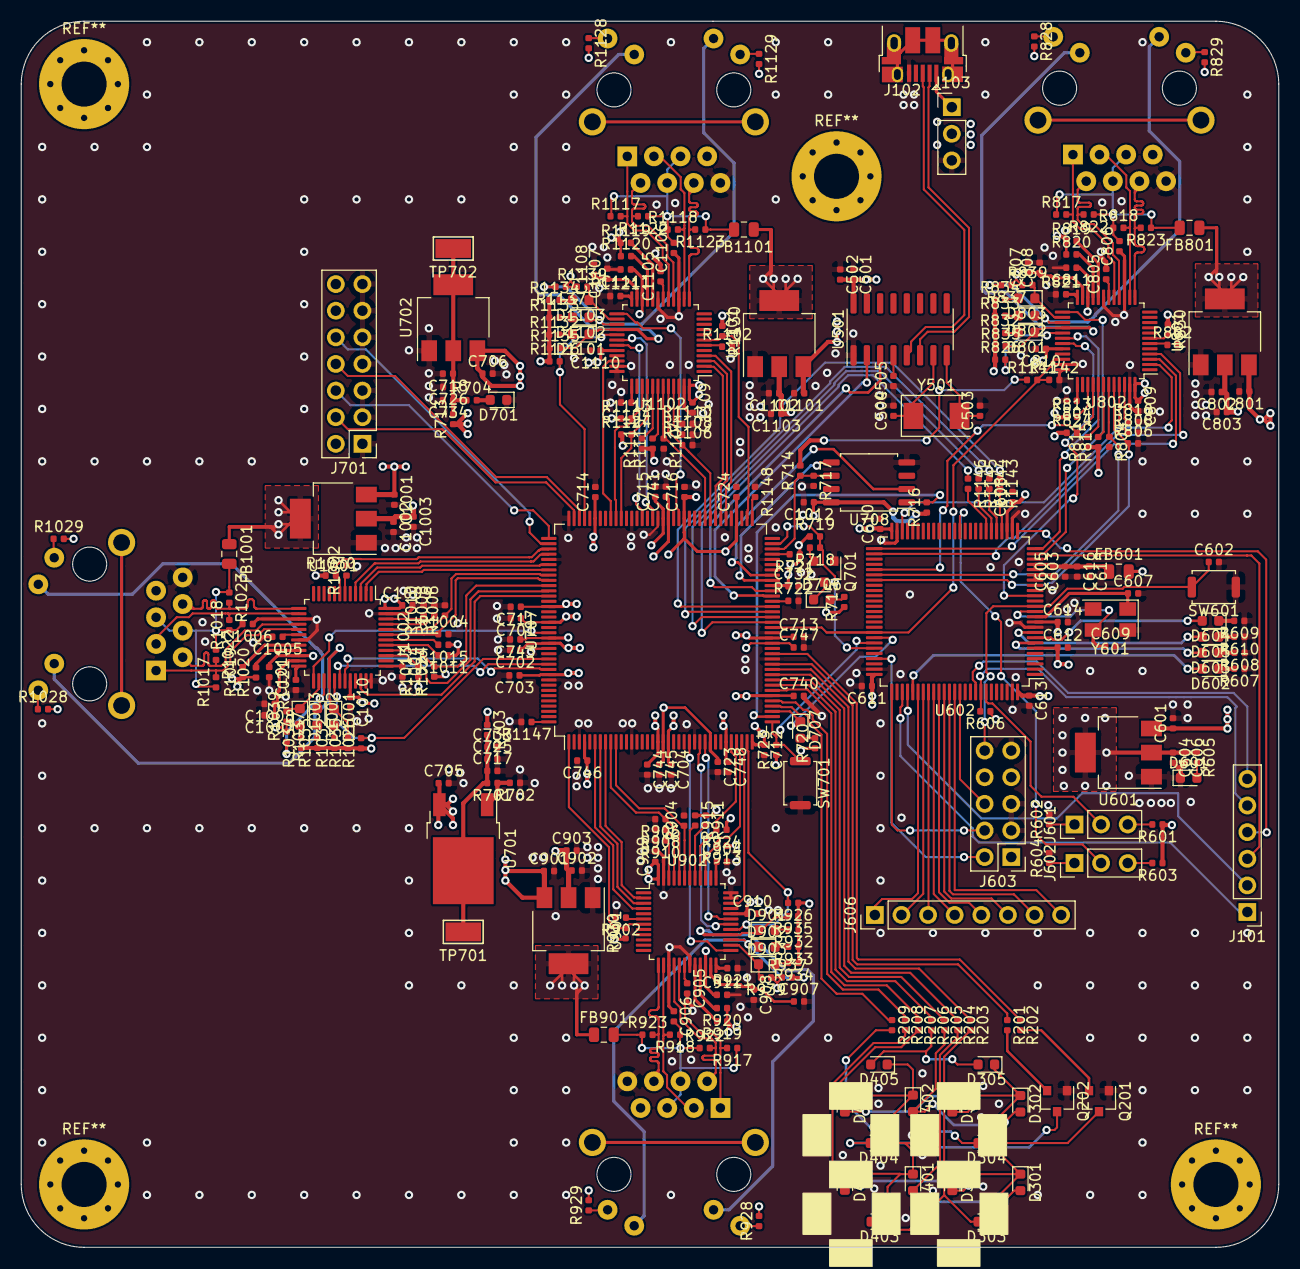
[picture p24: board ethernet-sniffer/ethernet-sniffer.kicad_pcb from above]

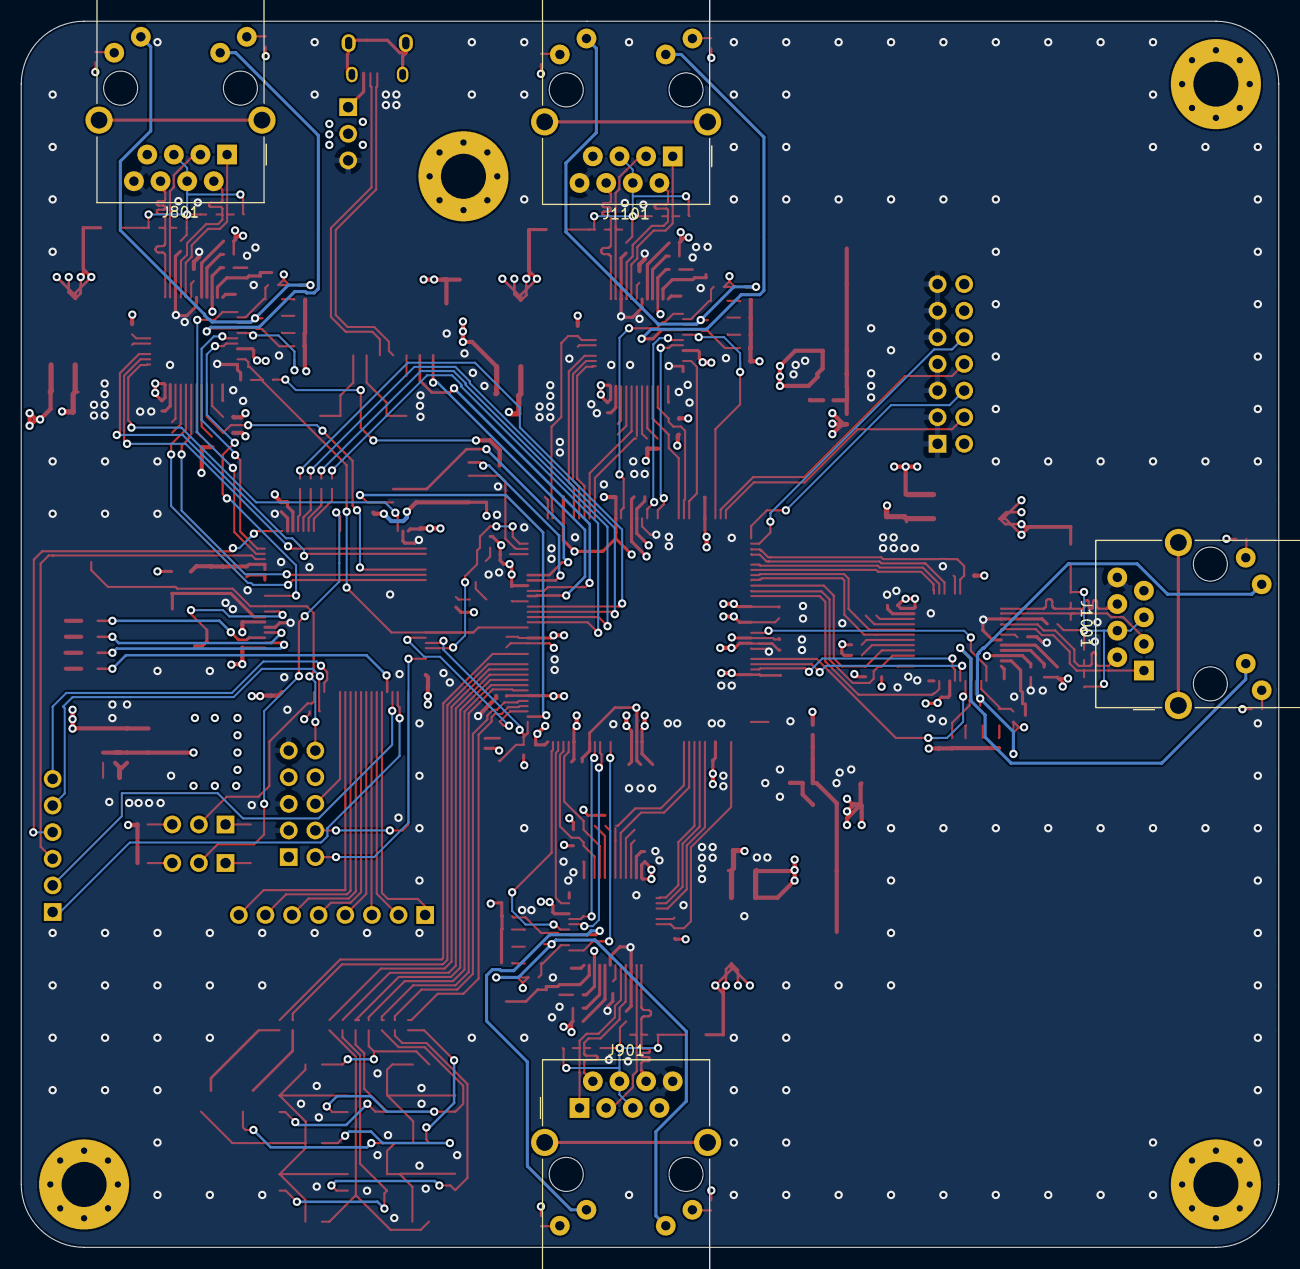
[picture p25: board ethernet-sniffer/ethernet-sniffer.kicad_pcb from below]

Board: 4 copper layers, 120.0 x 117.0 mm, 316 parts (4 on the bottom side), 252 nets.
