TheGreatChris/ethernet-sniffer/(commit log)

2020-06-03 Add files via upload
    Initial commit
    [7seg-display.sch, 7segment.sch, FPGA.sch, PHY.sch, USBUART.sch, ethernet-sniffer.kicad_pcb, ethernet-sniffer.sch, stm32.sch]
2020-06-04 Add files via upload
    Added PHY1-3
    [7seg-display.sch, 7segment.sch, FPGA.sch, PHY.sch, USBUART.sch, ethernet-sniffer.kicad_pcb, ethernet-sniffer.sch, stm32.sch]
2020-06-04 Add files via upload
    Added again in the right folder this time hopefully
    [7segment.sch, PHY.sch, ethernet-sniffer.kicad_pcb]
2020-06-25 PCB layout 90% finished
    [FPGA_LDO.sch, PHY_fixed_rmii.sch, USBUART.sch, ethernet-sniffer.kicad_pcb, ethernet-sniffer.sch, stm32.sch]
